Batuhxn/EMG/BOM_V4_NOTU.md

# BOM v4 notu

Mevcut `BOM.md` v2 fixed tabanidir. v4 icin buna ek olarak
`EMG_v4_EK_BOM.md` dosyasindaki parcalar eklenmelidir.

En kritik ekler:

- VREF buffer icin MCP6002'nin bos kanali kullanilacak.
- Girise dusuk kacakli dual ESD koruma ve seri direncler eklenecek.
- IN+, IN-, VREF, INA_OUT, RAW_Out, GND ve VCC test noktalari eklenecek.
- RAW_Out hattina 100 Ohm seri cikis direnci eklenebilir.

Bu not, v2 BOM dosyasinin encoding'ini bozmamak icin ayri tutuldu.
