Batuhxn/EMG/V5/BOM_V5_FINAL.md

# EMG V5 Final Purchasing BOM

> Source of truth: `V5/EMG_v5.kicad_pcb` and related current schematics/documentation on branch `v5/KiCad`. Price/stock snapshot: **2026-08-10**. The old `BOM_V5_DRAFT.md` was used only as context; the current PCB wins on conflicts.

## Scope and totals

- **49 grouped purchasing lines**, **113 required populated components**, and **2 DNP components**.
- **C304/C404 are DNP**. Nineteen PCB test pads and four mounting-hole footprints are excluded from purchasing.
- Prototype component subtotal: **86.03 USD + 363.69 TRY**. Shipping, customs and non-row VAT are excluded; the U501 TRY price includes VAT.
- Recommended buy quantities include modest prototype spares. Recheck MOQ, multiples, Turkey-region stock, incoterms and landed cost in the final carts.

| Preferred distributor | Currency | BOM lines | Recommended units | Subtotal |
|---|:---:|---:|---:|---:|
| LCSC | USD | 22 | 152 | 1.44 |
| DigiKey | USD | 23 | 117 | 63.95 |
| Not purchased | USD | 1 | 0 | 0.00 |
| Mouser | USD | 2 | 4 | 20.64 |
| Direnc.net | TRY | 1 | 1 | 363.69 |

## Verification gates

- `BAS70ZFILM` is obsolete. The priced `1N5711W-7-F` candidate is SOD-123/70V/low-capacitance Schottky class, but analog clamp leakage, Vf and capacitance need bench sign-off.
- `PMV48XP,215` had no authorized stock in the checked sources. `FDN304P` is a stocked P-channel SOT-23 candidate; G/S/D mapping, RDS(on), gate charge and inrush behavior must be approved.
- `TPS22917DBVT` is a verified packaging-only substitute for the out-of-stock `TPS22917DBVR` and is the priced purchase choice.
- `U501` is verified only as local supplier SKU `DSTK22807`; manufacturer MPN and physical 2x9 board revision/pinout remain `TBD/Verify`.
- `SW501` procurement MPN `TDA04H0SB1R` matches the electrical/lead-grid class, but the body/courtyard still needs a mechanical overlay against the KiCad footprint.
- `J301/J401` use the requested `SJ1-3523N`. `C213` is the verified `GRM32ER71A476KE15L` (47uF, 10V, X7R, 1210).

## Full purchasing table

Prices are per unit in the stated currency. `Ext.` uses the recommended buy quantity.

| RefDes | Qty / req / buy | Value | Manufacturer / exact MPN | Package / mounting | DNP | Preferred / unit / ext. | Product links | Availability | Verified alternative / compatibility | Verification status |
|---|---:|---|---|---|:---:|---|---|---|---|---|
| C203,C205,C208,C214,C215,C216,C217,C310,C311,C410,C411 | 11 / 11 / 20 | 100nF | Murata Electronics<br>`GRM188R71C104KA01D` | 0603 (1608 metric), X7R, 16V, ±10%<br>SMD | No | LCSC<br>0.006814 USD<br>0.14 USD | [buy](https://www.lcsc.com/product-detail/C45000.html)<br>[second source](https://www.digikey.com/en/products/result?keywords=GRM188R71C104KA01D) | LCSC C45000; 140,766 shown in stock. Recheck MOQ/multiple at checkout. | `CC0603KRX7R7BB104`<br>Same 0603/value/X7R class; verify voltage and DC-bias derating for the rail. | Verified – value, dielectric/tolerance and package matched; procurement MPN selected |
| C204,C206,C341,C441 | 4 / 4 / 10 | 1uF | Murata Electronics<br>`GRM21BR71C105KA01L` | 0805 (2012 metric), X7R, 16V, ±10%<br>SMD | No | DigiKey<br>0.14 USD<br>1.40 USD | [buy](https://www.digikey.com/en/products/detail/murata-electronics/GRM21BR71C105KA01L/587411)<br>[second source](https://www.mouser.com/c/?q=GRM21BR71C105KA01L) | DigiKey listing active; large stock indicated. Price basis is low-quantity cut tape; recheck cart. | `GRM21BR71C105MA01K`<br>Same 0805/1uF/16V X7R; ±20% alternative is electrically broader, not preferred for critical tolerance. | Verified – value, dielectric/tolerance and package matched; procurement MPN selected |
| C207 | 1 / 1 / 5 | 220pF | Murata Electronics<br>`GRM1885C1H221JA01D` | 0603 (1608 metric), C0G/NP0, 50V, ±5%<br>SMD | No | DigiKey<br>0.12 USD<br>0.60 USD | [buy](https://www.digikey.com/en/products/detail/murata-electronics/GRM1885C1H221JA01D/586961)<br>[second source](https://www.mouser.com/c/?q=GRM1885C1H221JA01D) | DigiKey showed 2,445 in stock; Murata part is NRND. Direct KEMET substitute available. | `C0603C221J5GACTU`<br>DigiKey-classified direct substitute; same 220pF ±5%, 50V, C0G, 0603. | Verified – exact part NRND; direct compatible alternative verified |
| C209,C210 | 2 / 2 / 5 | 2.2uF | Murata Electronics<br>`GRM21BR71A225KA01L` | 0805 (2012 metric), X7R, 10V, ±10%<br>SMD | No | DigiKey<br>0.18 USD<br>0.90 USD | [buy](https://www.digikey.com/en/products/detail/murata-electronics/GRM21BR71A225KA01L/446245)<br>[second source](https://www.mouser.com/c/?q=GRM21BR71A225KA01L) | DigiKey showed 288,072 in stock; active. | `GRM21BR71C225KA12L`<br>Upgrade: same 0805/value/tolerance/X7R with higher 16V rating; drop-in. | Verified – value, dielectric/tolerance and package matched; procurement MPN selected |
| C211,C314,C414 | 3 / 3 / 10 | 10nF | Murata Electronics<br>`GRM188R71H103KA01D` | 0603 (1608 metric), X7R, 50V, ±10%<br>SMD | No | LCSC<br>0.003957 USD<br>0.04 USD | [buy](https://www.lcsc.com/product-detail/C77053.html)<br>[second source](https://www.digikey.com/en/products/result?keywords=GRM188R71H103KA01D) | LCSC C77053; 248,887 shown in stock. Recheck MOQ/multiple. | `CC0603KRX7R9BB103`<br>Same 0603/value/X7R/50V class; drop-in after tolerance check. | Verified – value, dielectric/tolerance and package matched; procurement MPN selected |
| C212 | 1 / 1 / 5 | 2.2nF | Murata Electronics<br>`GRM1885C1H222JA01D` | 0603 (1608 metric), C0G/NP0, 50V, ±5%<br>SMD | No | LCSC<br>0.01 USD<br>0.06 USD | [buy](https://www.lcsc.com/product-detail/C77033.html)<br>[second source](https://www.digikey.com/en/products/result?keywords=GRM1885C1H222JA01D) | LCSC C77033; 24,839 shown in stock. C0G/NP0 selected for TPS22917 CT timing. | `C0603C222J5GACTU`<br>Same 0603/value/50V/C0G/±5%; drop-in. | Verified – value, dielectric/tolerance and package matched; procurement MPN selected |
| C213 | 1 / 1 / 2 | 47uF | Murata Electronics<br>`GRM32ER71A476KE15L` | 1210 (3225 metric), X7R, 10V, ±10%<br>SMD | No | LCSC<br>0.25 USD<br>0.51 USD | [buy](https://www.lcsc.com/product-detail/C84494.html)<br>[second source](https://www.digikey.com/en/products/detail/murata-electronics/GRM32ER71A476KE15L/2039039) | LCSC C84494 showed 61,880 in stock. DigiKey exact part showed 10,818; $0.91 at qty 1. | `GRM32ER71C476KE15L`<br>Potential voltage upgrade only if exact height/DC-bias and availability are confirmed; verify before substitution. | Verified – exact requested MPN, 47uF/10V/X7R/1210 confirmed |
| C218,C219 | 2 / 2 / 5 | 9.1nF | Murata Electronics<br>`GCM1885C1H912GA16D` | 0603 (1608 metric), C0G/NP0, 50V, ±2%<br>SMD | No | DigiKey<br>0.17 USD<br>0.85 USD | [buy](https://www.digikey.com/en/products/detail/murata-electronics/GCM1885C1H912GA16D/17845656)<br>[second source](https://www.mouser.com/c/?q=GCM1885C1H912GA16D) | DigiKey showed 3,820 in stock; Mouser also showed >10k region stock. TME exact part was out of stock. | `GCM1885C1H912JA16D`<br>Same value/package/voltage/C0G with ±5% tolerance; use only if filter tolerance budget allows. | Verified – value, dielectric/tolerance and package matched; procurement MPN selected |
| C301,C302,C401,C402 | 4 / 4 / 10 | 100pF | Murata Electronics<br>`GRM1885C1H101JA01D` | 0603 (1608 metric), C0G/NP0, 50V, ±5%<br>SMD | No | LCSC<br>0.009400 USD<br>0.09 USD | [buy](https://www.lcsc.com/product-detail/C71664.html)<br>[second source](https://www.digikey.com/en/products/result?keywords=GRM1885C1H101JA01D) | LCSC C71664; 20,137 shown in stock. Recheck MOQ/multiple. | `C0603C101J5GACTU`<br>Same 0603/value/50V/C0G/±5%; drop-in. | Verified – value, dielectric/tolerance and package matched; procurement MPN selected |
| C303,C403 | 2 / 2 / 5 | 470pF | Murata Electronics<br>`GRM1885C1H471JA01D` | 0603 (1608 metric), C0G/NP0, 50V, ±5%<br>SMD | No | LCSC<br>0.005614 USD<br>0.03 USD | [buy](https://www.lcsc.com/product-detail/C85979.html)<br>[second source](https://www.digikey.com/en/products/result?keywords=GRM1885C1H471JA01D) | LCSC C85979; 25,277 shown in stock. Recheck MOQ/multiple. | `C0603C471J5GACTU`<br>Same 0603/value/50V/C0G/±5%; drop-in. | Verified – value, dielectric/tolerance and package matched; procurement MPN selected |
| C304,C404 | 2 / 0 / 0 | 100pF DNP | Murata Electronics<br>`GRM1885C1H101JA01D` | 0603 (1608 metric), C0G/NP0, 50V, ±5%<br>SMD | Yes | Not purchased<br>0.000000 USD<br>0.00 USD | [buy](https://www.lcsc.com/product-detail/C71664.html)<br>[second source](https://www.digikey.com/en/products/result?keywords=GRM1885C1H101JA01D) | Explicit DNP per PCB; pads remain unpopulated. | `N/A`<br>Do not populate unless the analog filter is intentionally retuned and revalidated. | Verified – DNP flag confirmed on current PCB |
| C321,C331,C421,C431 | 4 / 4 / 10 | 1nF | KEMET<br>`C0805C102J5GACTU` | 0805 (2012 metric), C0G/NP0, 50V, ±5%<br>SMD | No | DigiKey<br>0.12 USD<br>1.20 USD | [buy](https://www.digikey.com/en/products/detail/kemet/C0805C102J5GACTU/411411)<br>[second source](https://www.mouser.com/c/?q=C0805C102J5GACTU) | DigiKey showed 409,004 in stock; active. | `GRM2165C1H102JA01J`<br>DigiKey-classified direct substitute; same 1nF/50V/C0G/0805. | Verified – value, dielectric/tolerance and package matched; procurement MPN selected |
| C351,C451 | 2 / 2 / 5 | 4.7nF | KEMET<br>`C0805C472J5GACTU` | 0805 (2012 metric), C0G/NP0, 50V, ±5%<br>SMD | No | DigiKey<br>0.57 USD<br>2.85 USD | [buy](https://www.digikey.com/en/products/detail/kemet/C0805C472J5GACTU/2212835)<br>[second source](https://www.mouser.com/c/?q=C0805C472J5GACTU) | DigiKey showed 13,585 in stock; active. | `C2012C0G1H472J125AA`<br>Same value/package/50V/C0G/±5%; verify thickness but electrically drop-in. | Verified – value, dielectric/tolerance and package matched; procurement MPN selected |
| C360,C460 | 2 / 2 / 5 | 100nF | KEMET<br>`C0805C104K5RACTU` | 0805 (2012 metric), X7R, 50V, ±10%<br>SMD | No | DigiKey<br>0.16 USD<br>0.80 USD | [buy](https://www.digikey.com/en/products/detail/kemet/C0805C104K5RACTU/411169)<br>[second source](https://www.mouser.com/c/?q=C0805C104K5RACTU) | DigiKey showed 5,631,275 in stock; active. | `CC0805KRX7R9BB104`<br>Same value/package/50V/X7R/±10%; drop-in. | Verified – value, dielectric/tolerance and package matched; procurement MPN selected |
| D331,D332,D431,D432 | 4 / 4 / 5 | BAS70ZFILM | STMicroelectronics<br>`BAS70ZFILM` | SOD-123<br>SMD | No | DigiKey<br>0.23 USD<br>1.15 USD | [buy](https://www.digikey.com/en/products/detail/diodes-incorporated/1N5711W-7-F/808531)<br>[second source](https://www.digikey.com/en/products/detail/stmicroelectronics/BAS70ZFILM/1299858) | Original BAS70ZFILM is obsolete/no stock. Price and availability use the listed alternative; 1N5711W-7-F showed ~29k in stock. | `1N5711W-7-F`<br>Same SOD-123, 70V low-capacitance Schottky class. DigiKey marks it direct for 1N5711W; analog clamp leakage/Vf/capacitance must be bench-verified against BAS70 behavior. | Verify before order – original obsolete; alternative is not formally manufacturer-qualified as BAS70 drop-in |
| J201 | 1 / 1 / 2 | B2B-XH-A(LF)(SN) | JST Sales America<br>`B2B-XH-A(LF)(SN)` | JST XH, 2-position, 2.50mm pitch, vertical<br>THT | No | Mouser<br>0.10 USD<br>0.20 USD | [buy](https://www.mouser.com/ProductDetail/JST-Commercial/B2B-XH-ALFSN)<br>[second source](https://www.digikey.com/en/products/result?keywords=B2B-XH-A(LF)(SN)) | Mouser showed tens of thousands globally; low-quantity price about $0.10. Recheck Turkey region at cart. | `B2B-XH-AM(LF)(SN)`<br>Similar JST XH header; verify boss/retention and exact PCB hole geometry before substitution. | Verified – exact JST MPN and 2-pin vertical THT package |
| J301,J401 | 2 / 2 / 3 | SJ1-3523N | Same Sky (formerly CUI Devices)<br>`SJ1-3523N` | 3.5mm stereo audio jack, right-angle PCB<br>THT | No | DigiKey<br>1.06 USD<br>3.18 USD | [buy](https://www.digikey.com/en/products/detail/same-sky-formerly-cui-devices/SJ1-3523N/738689)<br>[second source](https://www.mouser.com/ProductDetail/Same-Sky/SJ1-3523N) | DigiKey showed 234,333 in stock; active. | `TBD/Verify`<br>No second MPN approved. Jack pinout and board drill pattern are mechanical-critical. | Verified – user-specified MPN; THT right-angle TRS pinout/package confirmed |
| Q201 | 1 / 1 / 2 | PMV48XP | Nexperia<br>`PMV48XP,215` | SOT-23-3 (TO-236AB)<br>SMD | No | DigiKey<br>0.82 USD<br>1.64 USD | [buy](https://www.digikey.com/en/products/detail/onsemi/FDN304P/965599)<br>[second source](https://www.mouser.com/ProductDetail/Nexperia/PMV48XP215) | Original PMV48XP,215 showed no authorized stock. Price uses FDN304P; DigiKey showed 36,114 in stock. | `FDN304P`<br>P-channel 20V SOT-23 with 1.8V/4.5V drive. Same package class; verify G/S/D pad mapping, RDS(on), gate charge and inrush behavior before release. | Verify before order – functional alternative identified; engineering sign-off required |
| R201,R202 | 2 / 2 / 5 | 47k | YAGEO<br>`RC0805FR-0747KL` | 0805 (2012 metric), 1%, 1/8W<br>SMD | No | LCSC<br>0.004200 USD<br>0.02 USD | [buy](https://www.lcsc.com/product-detail/C126351.html)<br>[second source](https://www.digikey.com/en/products/result?keywords=RC0805FR-0747KL) | LCSC C126351; 172,145 shown in stock. | `ERJ-6ENF4702V`<br>Same 47k/1%/0805 power class; drop-in. | Verified – value, tolerance/power class and package matched; procurement MPN selected |
| R203 | 1 / 1 / 5 | 1k | YAGEO<br>`RC0603FR-071KL` | 0603 (1608 metric), 1%, 0.1W<br>SMD | No | LCSC<br>0.000943 USD<br>0.00 USD | [buy](https://www.lcsc.com/product-detail/C22548.html)<br>[second source](https://www.digikey.com/en/products/result?keywords=RC0603FR-071KL) | LCSC C22548; 5,102,062 shown in stock. | `ERJ-3EKF1001V`<br>Same 1k/1%/0603 power class; drop-in. | Verified – value, tolerance/power class and package matched; procurement MPN selected |
| R204 | 1 / 1 / 5 | 68k | YAGEO<br>`RC0805FR-0768KL` | 0805 (2012 metric), 1%, 1/8W<br>SMD | No | LCSC<br>0.004200 USD<br>0.02 USD | [buy](https://www.lcsc.com/product-detail/C114548.html)<br>[second source](https://www.digikey.com/en/products/result?keywords=RC0805FR-0768KL) | LCSC C114548; 165,801 shown in stock. | `ERJ-6ENF6802V`<br>Same 68k/1%/0805 power class; drop-in. | Verified – value, tolerance/power class and package matched; procurement MPN selected |
| R205,R311,R411 | 3 / 3 / 10 | 100k | YAGEO<br>`RC0805FR-07100KL` | 0805 (2012 metric), 1%, 1/8W<br>SMD | No | DigiKey<br>0.10 USD<br>1.00 USD | [buy](https://www.digikey.com/en/products/result?keywords=RC0805FR-07100KL)<br>[second source](https://www.lcsc.com/product-detail/C96346.html) | LCSC showed only 9 units, below recommended buy. DigiKey selected for adequate stock; recheck cut-tape tier. | `ERJ-6ENF1003V`<br>Same 100k/1%/0805 power class; drop-in. | Verified – value, tolerance/power class and package matched; procurement MPN selected |
| R206,R207 | 2 / 2 / 5 | 0R | YAGEO<br>`RC0603FR-070RL` | 0603 (1608 metric), jumper, 0.1W<br>SMD | No | LCSC<br>0.000943 USD<br>0.00 USD | [buy](https://www.lcsc.com/product-detail/C100044.html)<br>[second source](https://www.digikey.com/en/products/result?keywords=RC0603FR-070RL) | LCSC C100044; 1,323,481 shown in stock. | `ERJ-3GEY0R00V`<br>Same 0603 zero-ohm jumper class; drop-in. | Verified – value, tolerance/power class and package matched; procurement MPN selected |
| R208 | 1 / 1 / 5 | 10k | YAGEO<br>`RC0603FR-0710KL` | 0603 (1608 metric), 1%, 0.1W<br>SMD | No | LCSC<br>0.000957 USD<br>0.00 USD | [buy](https://www.lcsc.com/product-detail/C98220.html)<br>[second source](https://www.digikey.com/en/products/result?keywords=RC0603FR-0710KL) | LCSC C98220; 5,570,515 shown in stock. | `ERJ-3EKF1002V`<br>Same 10k/1%/0603 power class; drop-in. | Verified – value, tolerance/power class and package matched; procurement MPN selected |
| R209 | 1 / 1 / 5 | 47k 1% | YAGEO<br>`RC0603FR-0747KL` | 0603 (1608 metric), 1%, 0.1W<br>SMD | No | LCSC<br>0.001071 USD<br>0.01 USD | [buy](https://www.lcsc.com/product-detail/C105579.html)<br>[second source](https://www.digikey.com/en/products/result?keywords=RC0603FR-0747KL) | LCSC C105579; 767,590 shown in stock. | `ERJ-3EKF4702V`<br>Same 47k/1%/0603 power class; drop-in. | Verified – value, tolerance/power class and package matched; procurement MPN selected |
| R210 | 1 / 1 / 5 | 220k 1% | YAGEO<br>`RC0603FR-07220KL` | 0603 (1608 metric), 1%, 0.1W<br>SMD | No | LCSC<br>0.001900 USD<br>0.01 USD | [buy](https://www.lcsc.com/product-detail/C123420.html)<br>[second source](https://www.digikey.com/en/products/result?keywords=RC0603FR-07220KL) | LCSC C123420; 12,230 shown in stock. | `ERJ-3EKF2203V`<br>Same 220k/1%/0603 power class; drop-in. | Verified – value, tolerance/power class and package matched; procurement MPN selected |
| R301,R302,R401,R402 | 4 / 4 / 10 | 100k | YAGEO<br>`RC1206FR-07100KL` | 1206 (3216 metric), 1%, 1/4W<br>SMD | No | DigiKey<br>0.10 USD<br>1.00 USD | [buy](https://www.digikey.com/en/products/detail/yageo/RC1206FR-07100KL/728492)<br>[second source](https://www.mouser.com/c/?q=RC1206FR-07100KL) | DigiKey showed >700k exact-part availability in substitute listing context; active. | `ERJ-8ENF1003V`<br>Same 100k/1%/1206 power class; drop-in. | Verified – value, tolerance/power class and package matched; procurement MPN selected |
| R303,R403 | 2 / 2 / 5 | 220k | YAGEO<br>`RC1206FR-07220KL` | 1206 (3216 metric), 1%, 1/4W<br>SMD | No | LCSC<br>0.005800 USD<br>0.03 USD | [buy](https://www.lcsc.com/product-detail/C130275.html)<br>[second source](https://www.digikey.com/en/products/detail/yageo/RC1206FR-07220KL/728694) | LCSC C130275 showed 9 units; enough for recommended buy of 5, but recheck before checkout. | `ERJ-8ENF2203V`<br>Same 220k/1%/1206 power class; drop-in. | Verified – value, tolerance/power class and package matched; procurement MPN selected |
| R304,R305,R404,R405 | 4 / 4 / 10 | 10M | YAGEO<br>`RC1206FR-0710ML` | 1206 (3216 metric), 1%, 1/4W<br>SMD | No | LCSC<br>0.006300 USD<br>0.06 USD | [buy](https://www.lcsc.com/product-detail/C275643.html)<br>[second source](https://www.digikey.com/en/products/detail/yageo/RC1206FR-0710ML/728484) | LCSC C275643; 176 shown in stock. High-impedance node: keep board clean and verify leakage. | `CRCW120610M0FKEA`<br>Same 10M/1%/1206 class; verify voltage coefficient and max working voltage. | Verified – value, tolerance/power class and package matched; procurement MPN selected |
| R306,R406 | 2 / 2 / 5 | 2.2M | YAGEO<br>`RC1206FR-072M2L` | 1206 (3216 metric), 1%, 1/4W<br>SMD | No | LCSC<br>0.005500 USD<br>0.03 USD | [buy](https://www.lcsc.com/product-detail/C137329.html)<br>[second source](https://www.digikey.com/en/products/result?keywords=RC1206FR-072M2L) | LCSC C137329 showed 8 units; enough for recommended buy of 5, but recheck. | `CRCW12062M20FKEA`<br>Same 2.2M/1%/1206 class; verify voltage coefficient and working voltage. | Verified – value, tolerance/power class and package matched; procurement MPN selected |
| R307,R407 | 2 / 2 / 5 | 4.99k 0.1% RG | YAGEO<br>`RT0805BRD074K99L` | 0805 (2012 metric), thin film, 0.1%, 25ppm/°C<br>SMD | No | LCSC<br>0.05 USD<br>0.25 USD | [buy](https://www.lcsc.com/product-detail/C706246.html)<br>[second source](https://www.digikey.com/en/products/result?keywords=RT0805BRD074K99L) | LCSC C706246; 23,625 shown in stock. Precision gain resistor selection. | `TNPW08054K99BEEA`<br>Same 4.99k/0.1%/0805 precision thin-film class; verify TCR and power rating. | Verified – precision value, 0.1% tolerance and 0805 package matched |
| R313,R413 | 2 / 2 / 5 | 40.2k | YAGEO<br>`RC0805FR-0740K2L` | 0805 (2012 metric), 1%, 1/8W<br>SMD | No | LCSC<br>0.004100 USD<br>0.02 USD | [buy](https://www.lcsc.com/product-detail/C273827.html)<br>[second source](https://www.digikey.com/en/products/result?keywords=RC0805FR-0740K2L) | LCSC C273827; 197 shown in stock. | `ERJ-6ENF4022V`<br>Same 40.2k/1%/0805 power class; drop-in. | Verified – value, tolerance/power class and package matched; procurement MPN selected |
| R314,R341,R414,R441 | 4 / 4 / 10 | 33k | YAGEO<br>`RC0805FR-0733KL` | 0805 (2012 metric), 1%, 1/8W<br>SMD | No | LCSC<br>0.003500 USD<br>0.04 USD | [buy](https://www.lcsc.com/product-detail/C141696.html)<br>[second source](https://www.digikey.com/en/products/result?keywords=RC0805FR-0733KL) | LCSC C141696; 1,781 shown in stock. | `ERJ-6ENF3302V`<br>Same 33k/1%/0805 power class; drop-in. | Verified – value, tolerance/power class and package matched; procurement MPN selected |
| R321,R331,R351,R421,R431,R451 | 6 / 6 / 10 | 470R | YAGEO<br>`RC0805FR-07470RL` | 0805 (2012 metric), 1%, 1/8W<br>SMD | No | LCSC<br>0.003500 USD<br>0.04 USD | [buy](https://www.lcsc.com/product-detail/C114564.html)<br>[second source](https://www.digikey.com/en/products/result?keywords=RC0805FR-07470RL) | LCSC C114564; 280,999 shown in stock. | `ERJ-6ENF4700V`<br>Same 470R/1%/0805 power class; drop-in. | Verified – value, tolerance/power class and package matched; procurement MPN selected |
| R312,R333,R334,R337,R412,R433,R434,R437 | 8 / 8 / 20 | 10k | YAGEO<br>`RC0805FR-0710KL` | 0805 (2012 metric), 1%, 1/8W<br>SMD | No | DigiKey<br>0.10 USD<br>2.00 USD | [buy](https://www.digikey.com/en/products/detail/yageo/RC0805FR-0710KL/727535)<br>[second source](https://www.lcsc.com/product-detail/C84376.html) | LCSC showed only 2 units; DigiKey selected for adequate stock. Active exact MPN. | `ERJ-6ENF1002V`<br>Same 10k/1%/0805 power class; drop-in. | Verified – value, tolerance/power class and package matched; procurement MPN selected |
| R335,R435 | 2 / 2 / 5 | 1M | YAGEO<br>`RC0805FR-071ML` | 0805 (2012 metric), 1%, 1/8W<br>SMD | No | LCSC<br>0.002043 USD<br>0.01 USD | [buy](https://www.lcsc.com/product-detail/C107700.html)<br>[second source](https://www.digikey.com/en/products/result?keywords=RC0805FR-071ML) | LCSC C107700; 247,404 shown in stock. | `ERJ-6ENF1004V`<br>Same 1M/1%/0805 power class; drop-in. | Verified – value, tolerance/power class and package matched; procurement MPN selected |
| R336,R338,R436,R438 | 4 / 4 / 10 | 20k | YAGEO<br>`RC0805FR-0720KL` | 0805 (2012 metric), 1%, 1/8W<br>SMD | No | LCSC<br>0.003600 USD<br>0.04 USD | [buy](https://www.lcsc.com/product-detail/C114566.html)<br>[second source](https://www.digikey.com/en/products/result?keywords=RC0805FR-0720KL) | LCSC C114566 showed 23 units; enough for recommended buy of 10, but recheck. | `ERJ-6ENF2002V`<br>Same 20k/1%/0805 power class; drop-in. | Verified – value, tolerance/power class and package matched; procurement MPN selected |
| SW201 | 1 / 1 / 2 | TS02CQE | C&K<br>`TS02CQE` | TS series miniature slide switch, SPST ON-OFF<br>THT | No | Mouser<br>10.22 USD<br>20.44 USD | [buy](https://www.mouser.com/en/ProductDetail/CK/TS02CQE)<br>[second source](https://fr.farnell.com/en-FR/c-k-partner-stock/ts02cqe/switch-slide-spst-1a-120v/dp/4556613) | Mouser showed 412 in stock, min/multiple 1. Farnell partner stock existed but min/multiple 15. | `TBD/Verify`<br>No mechanically verified alternative approved; actuator and pin geometry are footprint-critical. | Verified – exact MPN and THT SPST function; stock available |
| SW501 | 1 / 1 / 2 | DEBUG_CFG | C&K<br>`TDA04H0SB1R` | 4-position SPST DIP slide, 7.62mm row spacing, 2.54mm pitch<br>THT | No | DigiKey<br>3.73 USD<br>7.46 USD | [buy](https://www.digikey.com/en/products/detail/c-k/TDA04H0SB1R/1961415)<br>[second source](https://www.mouser.com/c/?q=TDA04H0SB1R) | DigiKey direct-substitute listing showed 12,339 in stock. | `78B04ST`<br>Electrical class and lead grid are plausible; neither candidate's body/courtyard has been overlaid against the custom KiCad footprint. Mechanical verification required. | Verify before order – selected exact procurement MPN, mechanical fit not yet signed off |
| U201 | 1 / 1 / 2 | MCP3208-CI/P | Microchip Technology<br>`MCP3208-CI/P` | PDIP-16, 0.300in<br>THT | No | DigiKey<br>2.78 USD<br>5.56 USD | [buy](https://www.digikey.com/en/products/detail/microchip-technology/MCP3208-CI-P/305928)<br>[second source](https://www.mouser.com/c/?q=MCP3208-CI%2FP) | DigiKey showed 693 in stock; active. | `MCP3208-BI/P`<br>Same PDIP-16 pinout and function; B grade has tighter accuracy. Drop-in. | Verified – exact MPN/package aligned with PCB and repository review |
| U202 | 1 / 1 / 2 | MCP6002-I/SN | Microchip Technology<br>`MCP6002-I/SN` | SOIC-8, 3.9mm body<br>SMD | No | DigiKey<br>0.41 USD<br>0.82 USD | [buy](https://www.digikey.com/en/products/detail/microchip-technology/MCP6002-I-SN/500876)<br>[second source](https://www.mouser.com/c/?q=MCP6002-I%2FSN) | DigiKey showed 16,456 in stock; active. | `MCP6002T-I/SN`<br>Packaging-quantity suffix only; same silicon and SOIC-8 package. Drop-in. | Verified – exact MPN/package |
| U203 | 1 / 1 / 2 | TPS7A2033PDBVR | Texas Instruments<br>`TPS7A2033PDBVR` | SOT-23-5 (DBV)<br>SMD | No | DigiKey<br>0.35 USD<br>0.70 USD | [buy](https://www.digikey.com/en/products/detail/texas-instruments/TPS7A2033PDBVR/13566866)<br>[second source](https://www.mouser.com/c/?q=TPS7A2033PDBVR) | DigiKey showed 23,888 in stock; active. | `TPS7A2033PDBVT`<br>Packaging-quantity code; same DBV package and electrical device. Drop-in. | Verified – exact MPN/package |
| U204 | 1 / 1 / 2 | TPS22917DBVR | Texas Instruments<br>`TPS22917DBVR` | SOT-23-6 (DBV)<br>SMD | No | DigiKey<br>1.14 USD<br>2.28 USD | [buy](https://www.digikey.com/en/products/detail/texas-instruments/TPS22917DBVT/8567084)<br>[second source](https://www.digikey.com/en/products/detail/texas-instruments/TPS22917DBVR/8539916) | Original DBVR cut-tape listing showed 0 stock. DBVT packaging alternative showed ~6.9k in stock; price uses DBVT. | `TPS22917DBVT`<br>Same TPS22917 silicon and DBV package; R/T suffix is orderable packaging quantity. Drop-in. | Verified – packaging-only alternative approved for purchase |
| U205 | 1 / 1 / 2 | TXU0304PWR | Texas Instruments<br>`TXU0304PWR` | TSSOP-14 (PW)<br>SMD | No | DigiKey<br>0.99 USD<br>1.98 USD | [buy](https://www.digikey.com/en/products/detail/texas-instruments/TXU0304PWR/14641423)<br>[second source](https://www.mouser.com/c/?q=TXU0304PWR) | DigiKey showed 32,788 in stock; active. | `TXU0304PWT`<br>Likely packaging-quantity variant in the same PW package; verify TI ordering table before substitution. | Verified – exact MPN/package; alternative marked Verify |
| U206 | 1 / 1 / 2 | TPS3899DL30DSER | Texas Instruments<br>`TPS3899DL30DSER` | WSON-6, 1.5mm x 1.5mm (DSE)<br>SMD | No | DigiKey<br>1.47 USD<br>2.94 USD | [buy](https://www.digikey.com/en/products/detail/texas-instruments/TPS3899DL30DSER/15205114)<br>[second source](https://www.mouser.com/c/?q=TPS3899DL30DSER) | DigiKey showed 3,177 in stock; active. | `TPS3899DL30DSET`<br>Packaging-quantity variant expected in same DSE package; verify TI ordering table before substitution. | Verified – exact threshold MPN/package; alternative marked Verify |
| U207 | 1 / 1 / 2 | TPS3899DL29DSER | Texas Instruments<br>`TPS3899DL29DSER` | WSON-6, 1.5mm x 1.5mm (DSE)<br>SMD | No | DigiKey<br>1.47 USD<br>2.94 USD | [buy](https://www.digikey.com/en/products/detail/texas-instruments/TPS3899DL29DSER/15205155)<br>[second source](https://www.mouser.com/c/?q=TPS3899DL29DSER) | DigiKey showed 1,731 in stock; active. | `TPS3899DL29DSET`<br>Packaging-quantity variant expected in same DSE package; verify TI ordering table before substitution. | Verified – exact threshold MPN/package; alternative marked Verify |
| U301,U401 | 2 / 2 / 3 | INA333AIDGKT | Texas Instruments<br>`INA333AIDGKT` | VSSOP-8 (DGK)<br>SMD | No | DigiKey<br>6.36 USD<br>19.08 USD | [buy](https://www.digikey.com/en/products/detail/texas-instruments/INA333AIDGKT/1888776)<br>[second source](https://www.mouser.com/c/?q=INA333AIDGKT) | DigiKey showed 3,013 in stock; active. | `INA333AIDGKR`<br>Same device and DGK VSSOP-8 package; packaging-quantity suffix only. Drop-in. | Verified – exact MPN and custom PCB footprint package |
| U302,U402 | 2 / 2 / 3 | MCP6004-I/SL | Microchip Technology<br>`MCP6004-I/SL` | SOIC-14, 3.9mm body<br>SMD | No | DigiKey<br>0.54 USD<br>1.62 USD | [buy](https://www.digikey.com/en/products/detail/microchip-technology/MCP6004T-I-SL/523092)<br>[second source](https://www.digikey.com/en/products/detail/microchip-technology/MCP6004-I-SL/523061) | Tube MPN has MOQ 57. Cut-tape MCP6004T-I/SL showed 20,395 in stock; price uses T suffix. | `MCP6004T-I/SL`<br>Same silicon and SOIC-14 package; tape-and-reel ordering suffix. Drop-in. | Verified – packaging-only alternative selected to avoid tube MOQ |
| U501 | 1 / 1 / 1 | DSTK22807 / ESP32-H2 Super Mini | TBD/Verify (generic module)<br>`TBD/Verify; supplier SKU DSTK22807` | ESP32-H2 Super Mini dev board on custom 2x9 THT carrier<br>Module / THT headers | No | Direnc.net<br>363.69 TRY<br>363.69 TRY | [buy](https://www.direnc.net/esp32-h2-super-mini-bluetooth-board)<br>TBD/Verify | Direnc.net page showed 47 units; 303.07 TRY + VAT / 363.69 TRY incl. VAT. | `TBD/Verify`<br>No generic 'ESP32-H2 Super Mini' may be assumed drop-in. Physical board revision, 2x9 pin order, 3V3/GND and SPI pins must match repository measurement checklist. | Verify before order – supplier SKU is verified; manufacturer MPN and physical pinout are not |

## Checkout notes

- Prefer DigiKey/Mouser for ICs, semiconductors, connectors and switches where authenticity or lifecycle risk matters. LCSC is used only for exact, high-stock passive MPNs in this prototype plan.
- LCSC API/listing prices may reflect a displayed quantity tier; confirm MOQ and order multiple before checkout.
- All product URLs, second-source URLs, stock notes, alternatives and verification states are also preserved in the Excel deliverable.
