Batuhxn/EMG/EMG_v2_BOM_FIXED.xlsx

Sheet: BOM
Category | Ref | Value / MPN | Package | Qty | Purpose / Notes | Suggested source
IC | U1 | INA333AIDGKR | VSSOP-8 SMD | 1 | Instrumentation amplifier. Small SMD package; hot air or fine soldering needed. | direnc.net / Hepsiburada / Mouser
IC | U2 | MCP6002-I/P | DIP-8 THT | 1 | Dual rail-to-rail op-amp. | komponentci.net / entegredunyasi.com.tr / local
Resistor | Rg1, R2, R3 | 10 kOhm | Axial THT 1/4W | 3 | VREF divider and gain/bias network. | direnc.net / local
Resistor | R4, R5 | 2.2 kOhm | Axial THT 1/4W | 2 | Input series resistors. | direnc.net / local
Resistor | R6 | 4.7 kOhm | Axial THT 1/4W | 1 | High-pass bias resistor. | direnc.net / local
Resistor | R7 | 1 MOhm | Axial THT 1/4W | 1 | BODY_REF bias resistor. | direnc.net / local
Resistor | R8 | 1 kOhm | Axial THT 1/4W | 1 | RAW_Out low-pass filter resistor. | direnc.net / local
Resistor | Rf1 | 100 kOhm | Axial THT 1/4W | 1 | MCP6002 feedback resistor. | direnc.net / local
Resistor | Rg_HPF1 | 10 kOhm | Axial THT 1/4W | 1 | INA333 gain resistor. | direnc.net / local
Capacitor | C2, C5, C6 | 100 nF | Disc ceramic THT, 5 mm pitch | 3 | Bypass / reference decoupling capacitors. | direnc.net / local
Capacitor | C3 | 10 uF | Radial electrolytic D5 x P2.5 mm | 1 | VREF filtering. Observe polarity. | direnc.net / local
Capacitor | C4 | 2.2 uF | Film/polyester THT, 5 mm pitch | 1 | Critical high-pass capacitor. Do not use polarized electrolytic here. | direnc.net / komponentci.net
Capacitor | Cf2 | 330 nF | Disc ceramic or film THT, 5 mm pitch | 1 | RAW_Out low-pass filter capacitor. | direnc.net / komponentci.net
Connector | J1 | Pin Header 1x3 | 2.54 mm vertical THT | 1 | Electrode input: IN+, IN-, BODY_REF. | direnc.net / robotistan.com / local
Connector | J2 | Pin Header 1x4 | 2.54 mm vertical THT | 1 | Power/output: VCC, RAW_Out, VREF, GND. | direnc.net / robotistan.com / local

Sheet: Notes
Item | Status / Note
Project copy | Generated from EMG_v2_working_package_FIXED.
PCB sync | C2 is present on PCB as 100 nF between VREF and GND.
Gerbers | Gerbers must be regenerated from the FIXED KiCad project before fabrication.
Remaining layout warning | IN+ / IN- trace length mismatch remains; acceptable for low-frequency EMG but symmetry can be improved.
Safety | Input ESD / patient-side protection is still not implemented. Use battery power for any body-connected test.
No MPN coverage | Most passives are generic values; choose concrete manufacturer part numbers before production ordering.
