Batuhxn/EMG/EMG_v4_BOM_ve_Validasyon.xlsx

Sheet: v4 BOM
Grup | Ref | Deger / Parca | Paket | Adet | Durum | Not
IC | U1 | INA333AIDGKR | VSSOP-8 | 1 | Mevcut | Enstrumantasyon amplifikatoru
IC | U2 | MCP6002-I/P | DIP-8 | 1 | Mevcut | U2B VREF buffer olarak kullanilacak
Direnc | R2, R3 | 10 kOhm %1 | Axial THT | 2 | Mevcut | VREF_RAW bolucu
Direnc | Rg1, Rg_HPF1 | 10 kOhm %1 | Axial THT | 2 | Mevcut | Kazanc / filtre agi
Direnc | R4, R5 | 2.2 kOhm veya v4'te 10 kOhm | Axial THT | 2 | Revize | Giris seri koruma netlestirilecek
Direnc | R6 | 4.7 kOhm | Axial THT | 1 | Mevcut | HPF bias
Direnc | R7 | 1 MOhm | Axial THT | 1 | Mevcut | BODY_REF bias
Direnc | R8 | 1 kOhm | Axial THT | 1 | Mevcut | LPF seri direnc
Direnc | Rf1 | 100 kOhm | Axial THT | 1 | Mevcut | MCP6002 geri besleme
Direnc | R_INP | 10 kOhm %1 | Axial THT | 1 | Yeni | IN+ seri koruma
Direnc | R_INN | 10 kOhm %1 | Axial THT | 1 | Yeni | IN- seri koruma
Direnc | R_OUT | 100 Ohm | Axial THT | 1 | Yeni | RAW_Out seri cikis direnci
Kondansator | C2, C5, C6 | 100 nF | THT 5 mm | 3 | Mevcut | Bypass / VREF filtreleme
Kondansator | C3 | 10 uF | Radial THT | 1 | Mevcut | VREF filtreleme, polarite kontrol
Kondansator | C4 | 2.2 uF film/polyester | THT 5 mm | 1 | Mevcut kritik | Non-polar olmali
Kondansator | Cf2 | 330 nF | THT 5 mm | 1 | Mevcut | LPF kondansatoru
Kondansator | C_DIFF | 1 nF C0G/NP0 | THT/SMD | 1 | Yeni | IN+ ile IN- arasi RF bastirma
Kondansator | C_CM_P, C_CM_N | 100 pF C0G/NP0 | THT/SMD | 2 | Yeni opsiyonel | VREF'e ortak-mod RF bastirma, DNP olabilir
Koruma | D1 | Low leakage dual ESD diode | SOT-23/SOT-563 | 1 | Yeni | IN+ ve IN- giris ESD koruma
Konnektor | J1 | 1x3 erkek pin header | 2.54 mm THT | 1 | Mevcut | IN+, IN-, BODY_REF
Konnektor | J2 | 1x4 erkek pin header | 2.54 mm THT | 1 | Mevcut | VCC, RAW_Out, VREF, GND
Test | TP1-TP7 | Test point | THT/SMD pad | 7 | Yeni | IN+, IN-, VREF, INA_OUT, RAW_Out, GND, VCC

Sheet: Tasarim Kararlari
Baslik | Karar
VREF | R2/R3 orta noktasi VREF_RAW; U2B voltage follower cikisi VREF olacak.
Giris koruma | Seri direnc + dusuk kacakli ESD + C_DIFF eklenecek.
Elektrot | Ag/AgCl jel elektrot, 20 mm hedef aralik, kas lifine paralel.
Guc | Insan testinde sadece batarya; prize/USB'ye bagli sistemle vucut baglanmayacak.
Gerber | v4 Gerber bu ortamda uretilmedi; KiCad'de DRC/ERC sonrasi export edilecek.

Sheet: Validasyon
Test | Kabul kriteri | Sonuc | Not
Gorsel kontrol | Lehim koprusu yok, C3 polarite dogru, C4 non-polar
VREF 3.3V | 1.65 V +/- 5%
VREF 5V | 2.50 V +/- 5%
Frekans 20-250 Hz | Kullanilabilir genlik, raylara yapisma yok
500 Hz | LPF etkisi baslamis olmali
Gurultu | IN+/IN- VREF'e bagliyken RAW_Out VREF civarinda
Insan hafif kasilma | RMS dinlenmeden belirgin yuksek
Insan guclu kasilma | RMS hafiften yuksek, clipping yok

Sheet: Kaynaklar
Konu | Kaynak
SENIAM elektrot yerlesimi | https://seniam.org/fixation.htm
ADI biopotansiyel elektrotlar | https://www.analog.com/en/resources/technical-articles/biopotential-electrode-sensors-ecg-eeg-emg.html
TI INA333 datasheet | https://www.ti.com/lit/ds/symlink/ina333.pdf
FDA EMG siniflandirma | https://www.law.cornell.edu/cfr/text/21/890.1375
IEC 60601 genel guvenlik | https://www.vde.com/topics-en/health/consulting/electrical-safety-in-active-medical-devices--the-iec-60601-1-standard
