Batuhxn/EMG/EMG_kullanilacak_komponentler_BoM.xlsx

Sheet: EMG BoM
kullanım biçimi / tasarım | Sensör Model Adı ve No | Tedarikçi Linki | Stok Durumu | Birim Fiyat | (Varsa) Alternatif öneri | Modülün ürettiği veri çıkışı | Haberleşme Protokolü | makale kaynağı
EMG Sensör | INA333AIDGKR Enstrümantasyon Op-Amp | https://www.direnc.net/ina333aidgkr-smd-amplifikator-entegresi-vssop8-en | kontrol edilecek |  | INA333 muadili, aynı VSSOP-8 pinout doğrulanmalı | Analog EMG ön yükseltme | Analog
EMG Sensör | MCP6002-I/P Op-Amp | https://www.komponentci.net/mcp6002-i-p-islemsel-amplifikator-entegresi-dip-8-pmu9149 | kontrol edilecek |  | MCP6002 DIP-8 veya aynı pinout rail-to-rail çift op-amp | Kazanç ve filtre katı | Analog
EMG Sensör | 10 kΩ direnç |  | kontrol edilecek |  | 1/4W axial THT, %1 önerilir | Rg1, R2, R3, Rg_HPF1 için | Pasif
EMG Sensör | 2.2 kΩ direnç |  | kontrol edilecek |  | 1/4W axial THT, %1 önerilir | R4, R5 giriş seri dirençleri | Pasif
EMG Sensör | 4.7 kΩ direnç |  | kontrol edilecek |  | 1/4W axial THT, %1 önerilir | R6 HPF bias direnci | Pasif
EMG Sensör | 1 MΩ direnç |  | kontrol edilecek |  | 1/4W axial THT, %1 önerilir | R7 BODY_REF bias direnci | Pasif
EMG Sensör | 1 kΩ direnç |  | kontrol edilecek |  | 1/4W axial THT, %1 önerilir | R8 RAW_Out filtre direnci | Pasif
EMG Sensör | 100 kΩ direnç |  | kontrol edilecek |  | 1/4W axial THT, %1 önerilir | Rf1 geri besleme direnci | Pasif
EMG Sensör | 100 nF seramik kondansatör |  | kontrol edilecek |  | THT disk seramik, 5 mm adım | C2, C5, C6 bypass / VREF filtreleme | Pasif
EMG Sensör | 10 µF elektrolitik kondansatör |  | kontrol edilecek |  | Radial THT, polariteye dikkat | C3 VREF filtreleme | Pasif
EMG Sensör | 2.2 µF film/polyester kondansatör |  | kontrol edilecek |  | 5 mm adım, non-polar; elektrolitik kullanılmamalı | C4 yüksek geçiren filtre | Pasif
EMG Sensör | 330 nF kondansatör |  | kontrol edilecek |  | THT seramik veya film, 5 mm adım | Cf2 RAW_Out alçak geçiren filtre | Pasif
EMG Sensör | 1x3 pin header |  | kontrol edilecek |  | 2.54 mm dikey THT | J1 elektrot girişi | Konnektör
EMG Sensör | 1x4 pin header |  | kontrol edilecek |  | 2.54 mm dikey THT | J2 besleme ve çıkış | Konnektör

Sheet: Notlar
Başlık | Not
Kaynak proje | EMG_v2_working_package_FIXED
Parça sayımı | Bileşenler şemadaki son FIXED değerlere göre listelendi.
Stok/Fiyat | Pasif parçalar için kesin stok/fiyat yazılmadı; tedarik sırasında kontrol edilmeli.
C4 notu | C4 için 2.2 µF film/polyester veya uygun non-polar kondansatör kullanılmalı.
Güvenlik | Hasta/elektrot tarafı koruma devresi hala eksik; insan üzerinde kullanımda dikkat edilmeli.
Gerber | Üretim öncesi FIXED KiCad projesinden Gerber yeniden export edilmeli.
Çıkış | RAW_Out analog ADC/osiloskop çıkışıdır.
