Batuhxn/EMG/V5/ESP32 H2 Supermini.step

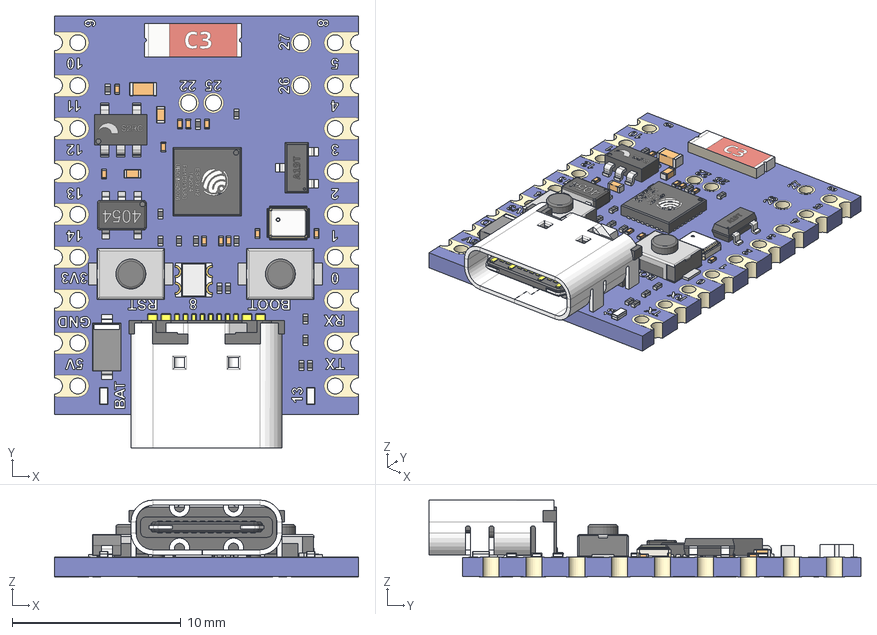
[picture p1: CAD file, 2026-07-01]
V5/ESP32 H2 Supermini.step
18.0 x 25.6 x 4.54 mm
USB_type_C_smd_12p
SMD Ceramic Antenna
Light x 2
Cathode Mark x 2
Anode Pin x 2
Cathode Pin x 2
Base x 2
3x4x2mm - 2 button x 2
WS2812-2020
Yageo-RC0201 x 14
Cathode
Anode
Cathode Bar
2520 SMD Crystal Oscillator
TP4054-SOT23 v2
ME6211-SOT23 v2
Board
Top
Bottom
