Batuhxn/EMG/V5/EMG_v5.kicad_pcb

## KiCad design V5/EMG_v5.kicad_pcb (2026-08-07)

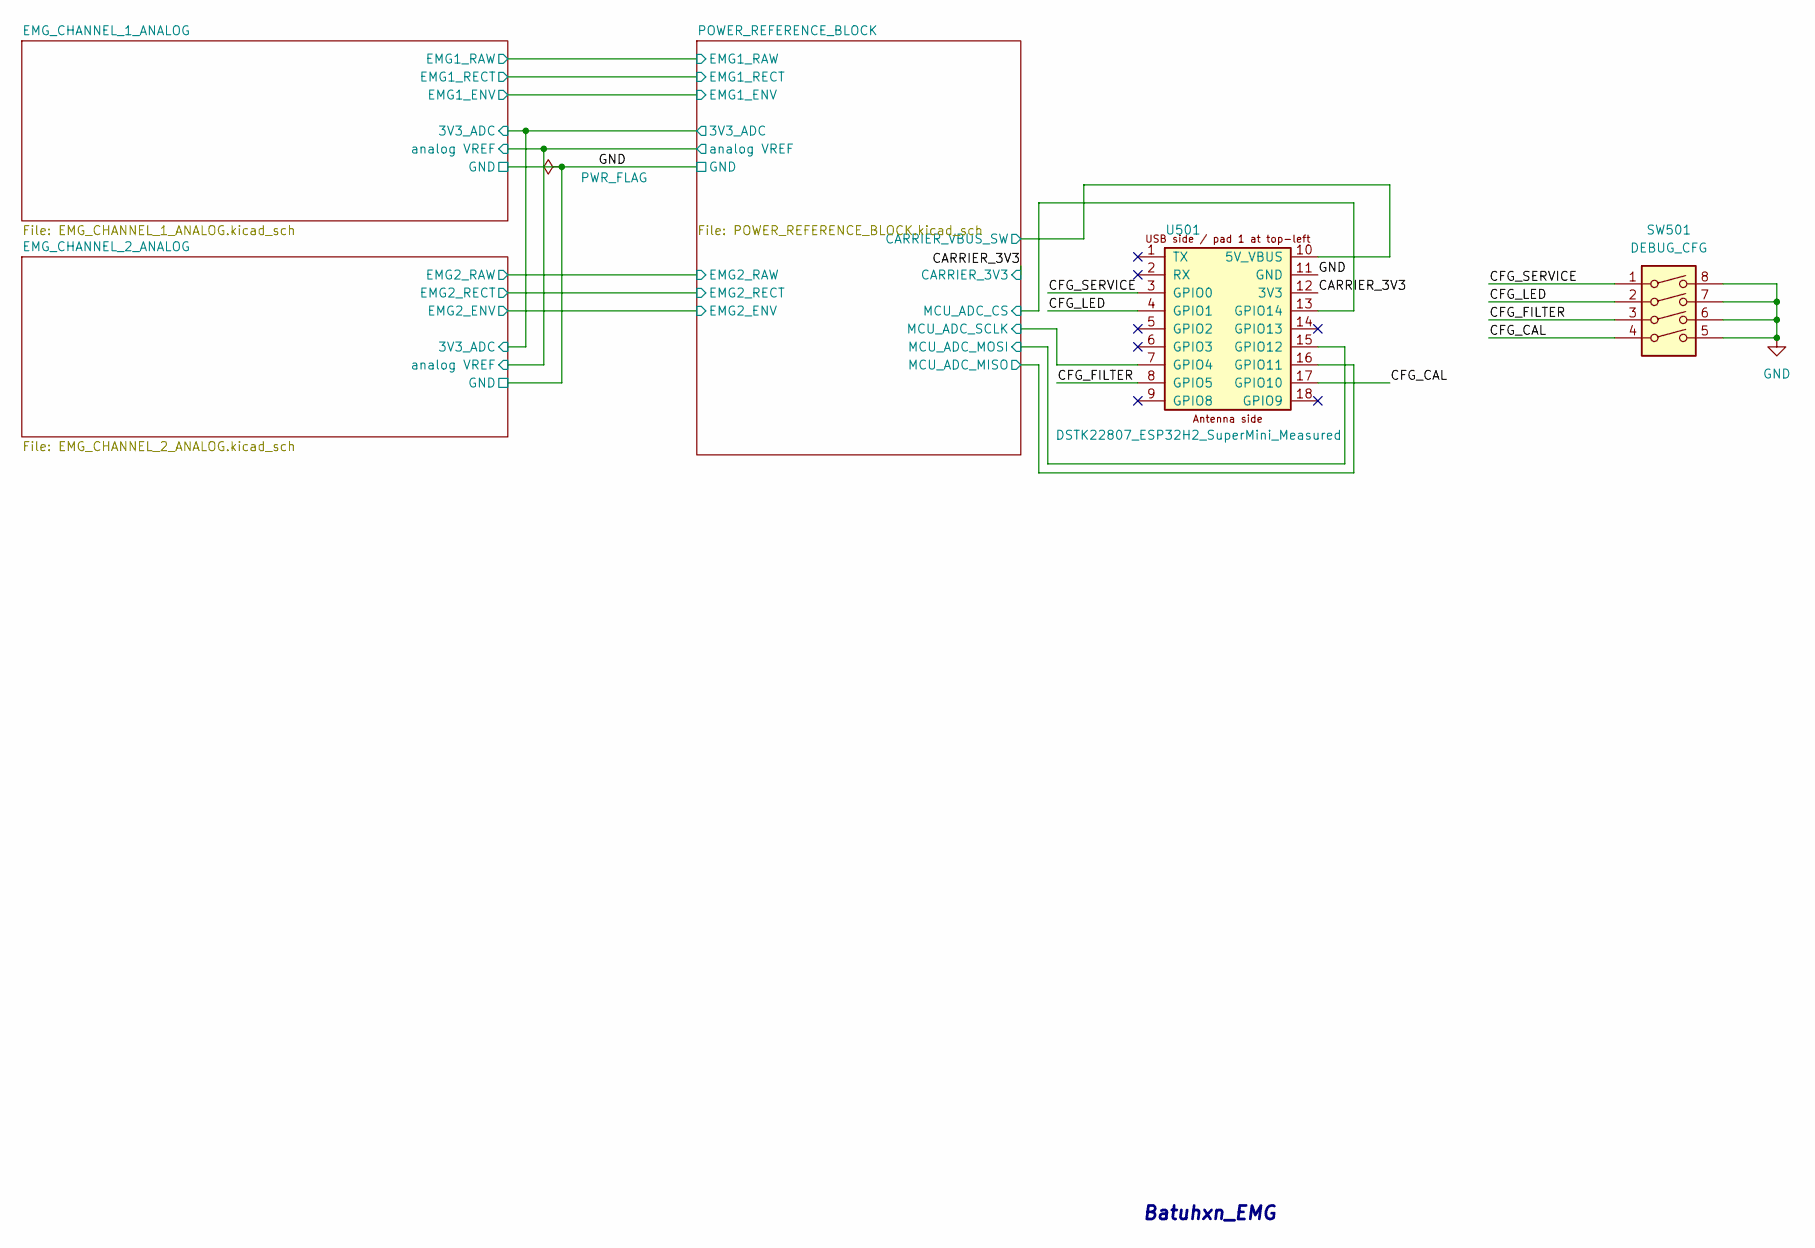
[picture p2: schematic EMG_v5.kicad_sch]

Parts:
SW501: DEBUG_CFG; SW_DIP_SPSTx04_Slide_9.78x12.34mm_W7.62mm_P2.54mm
U501: DSTK22807_ESP32H2_SuperMini_Measured; DSTK22807_ESP32H2_SuperMini_Carrier_Measured_THT

Connections:
/CARRIER_3V3: U501.12 (3V3); also elsewhere on the board
/CFG_CAL: SW501.4, U501.17 (GPIO10)
/CFG_FILTER: SW501.3, U501.8 (GPIO5)
/CFG_LED: SW501.2, U501.4 (GPIO1)
/CFG_SERVICE: SW501.1, U501.3 (GPIO0)
/POWER_REFERENCE_BLOCK/CARRIER_VBUS_SW: U501.10 (5V_VBUS); also elsewhere on the board
/POWER_REFERENCE_BLOCK/MCU_ADC_CS: U501.13 (GPIO14); also elsewhere on the board
/POWER_REFERENCE_BLOCK/MCU_ADC_MISO: U501.16 (GPIO11); also elsewhere on the board
/POWER_REFERENCE_BLOCK/MCU_ADC_MOSI: U501.15 (GPIO12); also elsewhere on the board
/POWER_REFERENCE_BLOCK/MCU_ADC_SCLK: U501.7 (GPIO4); also elsewhere on the board
GND: SW501.5, SW501.6, SW501.7, SW501.8, U501.11 (GND); also elsewhere on the board

Notes on the sheet:
Batuhxn_EMG

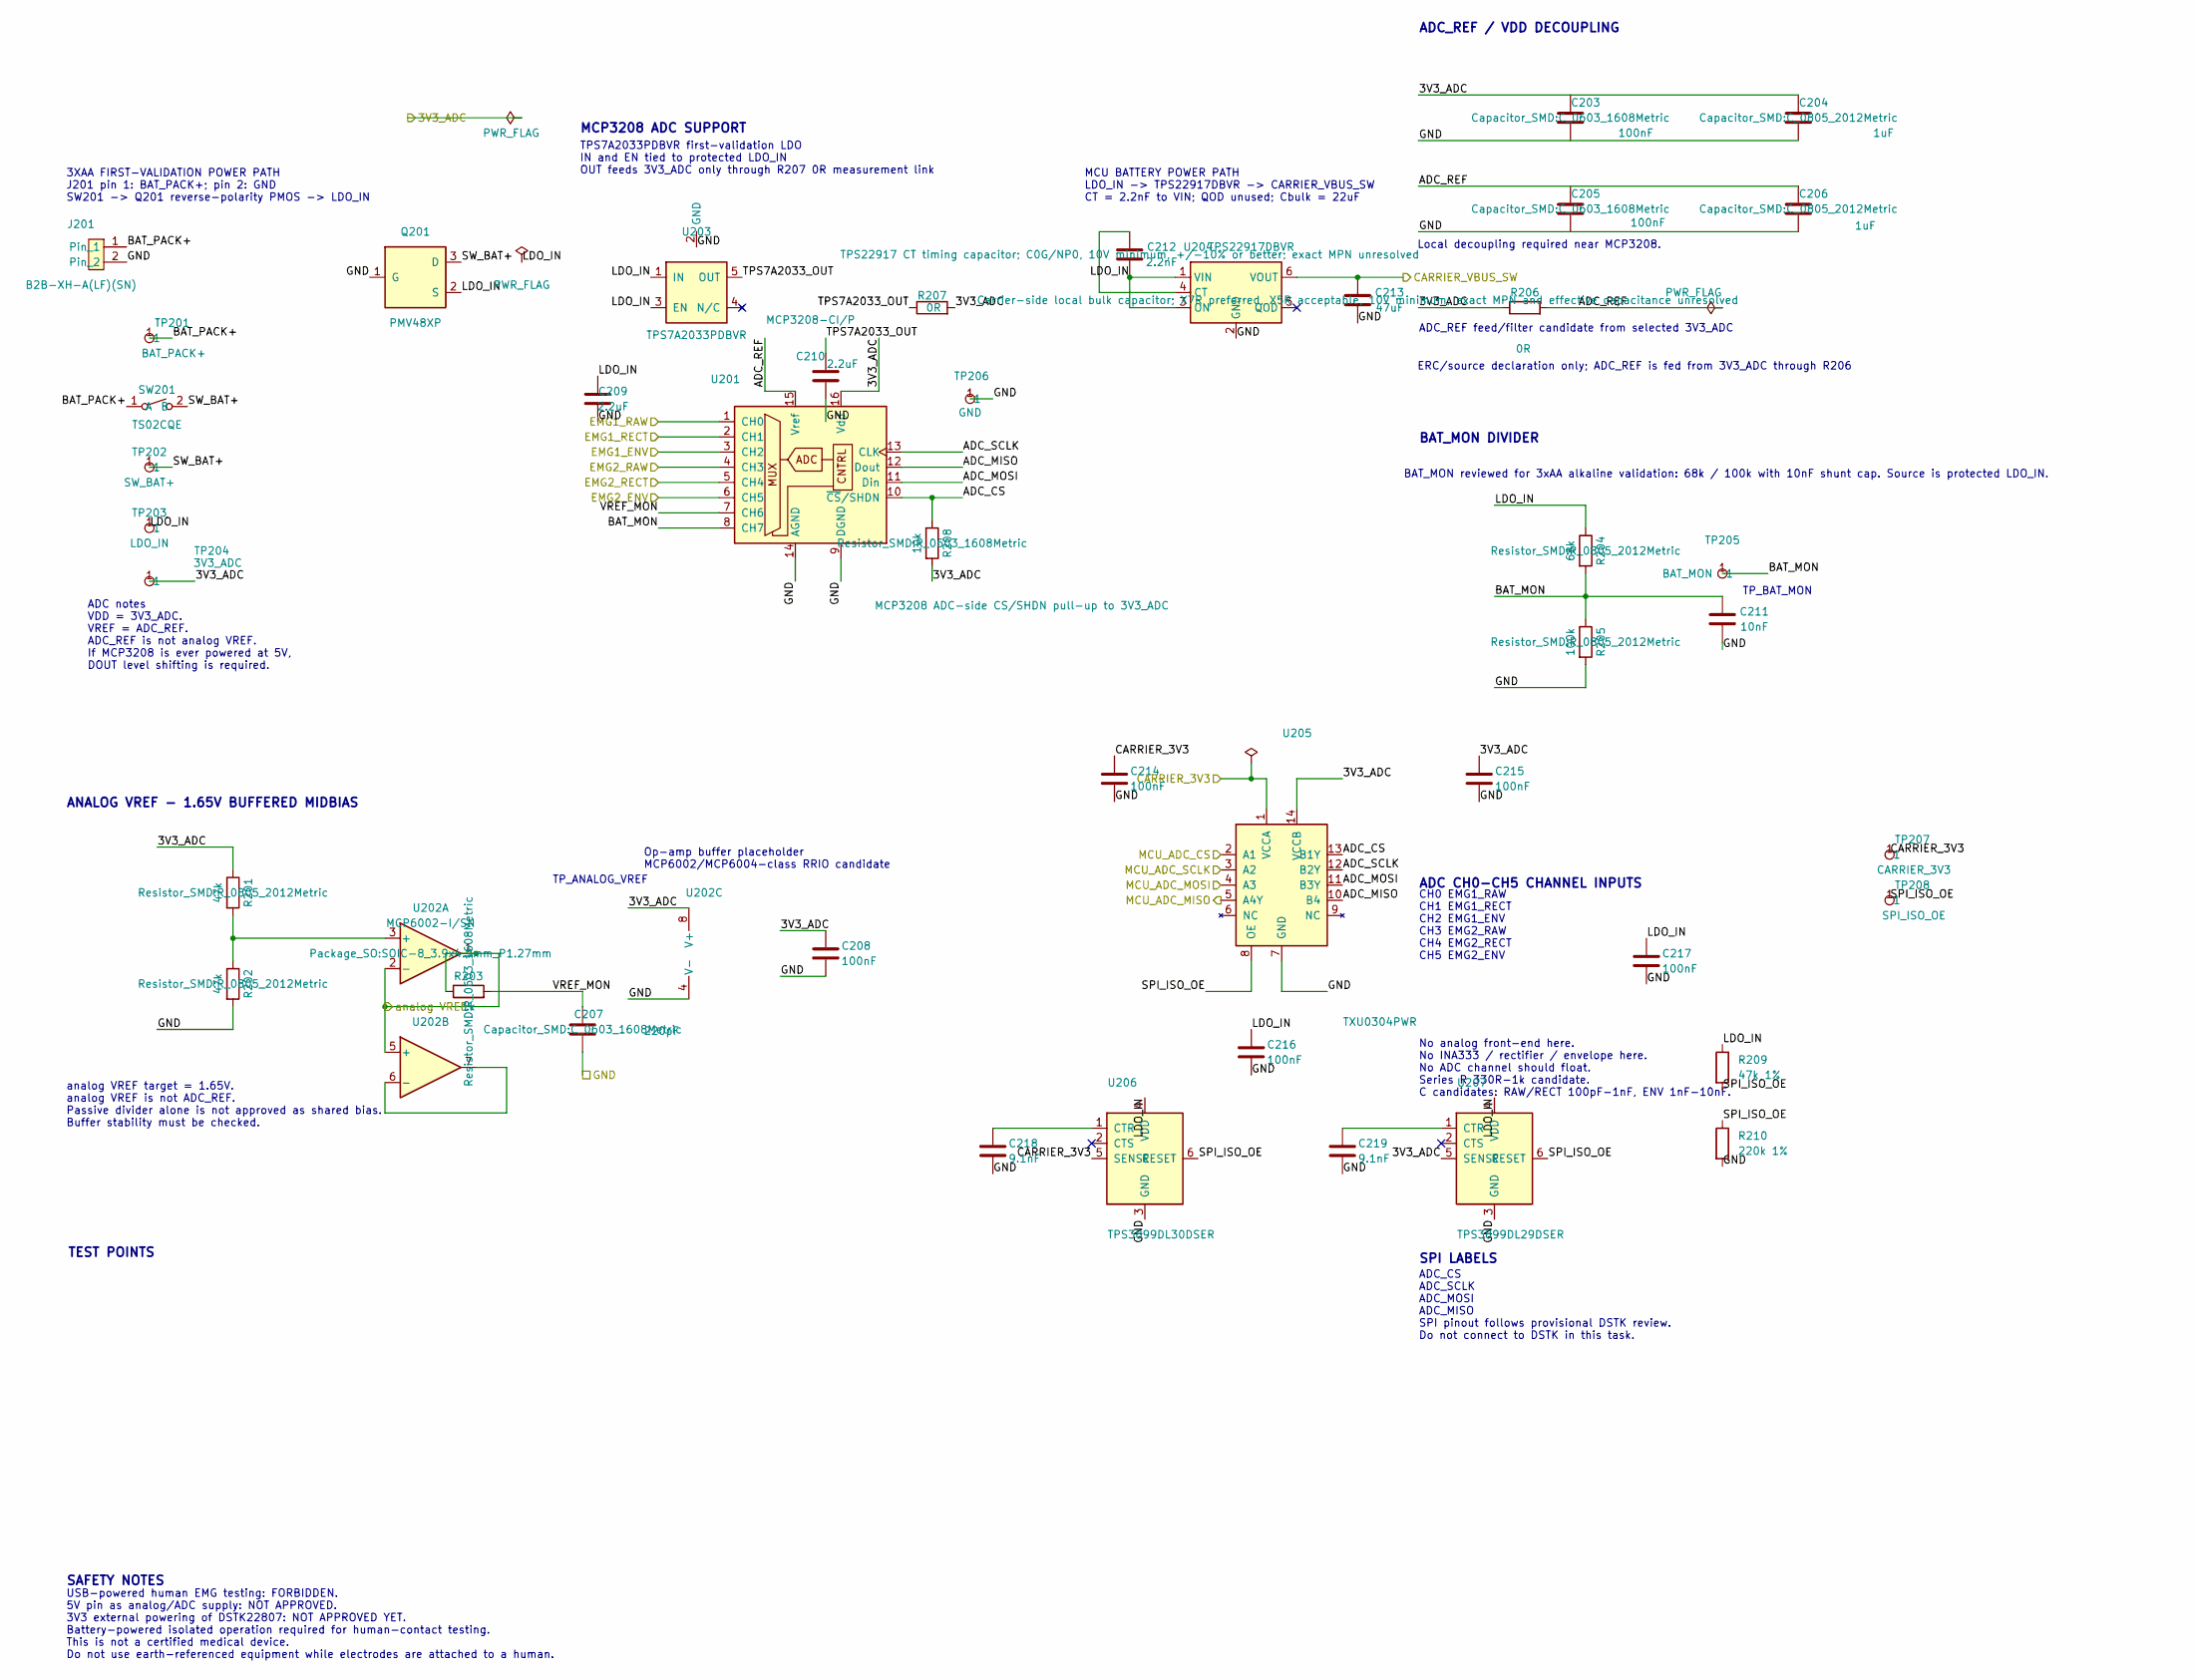
[picture p3: schematic POWER_REFERENCE_BLOCK.kicad_sch]

Parts:
C203, C205, C208, C214, C215, C216, C217: 100nF; C_0603_1608Metric
C204, C206: 1uF; C_0805_2012Metric
C207: 220pF; C_0603_1608Metric
C209, C210: 2.2uF; C_0805_2012Metric
C211: 10nF; C_0603_1608Metric
C212: 2.2nF; C_0603_1608Metric
C213: 47uF; C_1210_3225_Murata_GRM32_Reflow
C218, C219: 9.1nF; C_0603_1608Metric
J201: B2B-XH-A(LF)(SN); JST_XH_B2B-XH-A_1x02_P2.50mm_Vertical
Q201: PMV48XP; SOT-23
R201, R202: 47k; R_0805_2012Metric
R203: 1k; R_0603_1608Metric
R204: 68k; R_0805_2012Metric
R205: 100k; R_0805_2012Metric
R206, R207: 0R; R_0603_1608Metric
R208: 10k; R_0603_1608Metric
R209: 47k 1%; R_0603_1608Metric
R210: 220k 1%; R_0603_1608Metric
SW201: TS02CQE; TS02CQE_SPST_THT
TP201: BAT_PACK+; TestPoint_Pad_D1.0mm
TP202: SW_BAT+; TestPoint_Pad_D1.0mm
TP203: LDO_IN; TestPoint_Pad_D1.0mm
TP204: 3V3_ADC; TestPoint_Pad_D1.0mm
TP205: BAT_MON; TestPoint_Pad_D1.0mm
TP206: GND; TestPoint_Pad_D1.0mm
TP207: CARRIER_3V3; TestPoint_Pad_D1.0mm
TP208: SPI_ISO_OE; TestPoint_Pad_D1.0mm
U201: MCP3208-CI/P; DIP-16_W7.62mm
U202: MCP6002-I/SN; SOIC-8_3.9x4.9mm_P1.27mm
U203: TPS7A2033PDBVR; SOT-23-5
U204: TPS22917DBVR; SOT-23-6
U205: TXU0304PWR; TSSOP-14_4.4x5mm_P0.65mm
U206: TPS3899DL30DSER; WSON-6_1.5x1.5mm_P0.5mm
U207: TPS3899DL29DSER; WSON-6_1.5x1.5mm_P0.5mm

Connections:
/CARRIER_3V3: C214.1, TP207.1 (1_1), U205.1 (VCCA), U206.5 (SENSE); also elsewhere on the board
/EMG_CHANNEL_1_ANALOG/3V3_ADC: C203.1, C204.1, C208.1, C215.1, R201.1, R206.1, R207.2, R208.2, TP204.1 (1_1), U201.16 (Vdd), U202.8 (V+), U205.14 (VCCB), U207.5 (SENSE); also elsewhere on the board
/EMG_CHANNEL_1_ANALOG/EMG1_ENV: U201.3 (CH2); also elsewhere on the board
/EMG_CHANNEL_1_ANALOG/EMG1_RAW: U201.1 (CH0); also elsewhere on the board
/EMG_CHANNEL_1_ANALOG/EMG1_RECT: U201.2 (CH1); also elsewhere on the board
/EMG_CHANNEL_1_ANALOG/analog VREF: R203.1, U202.1, U202.2 (-), U202.5 (+); also elsewhere on the board
/EMG_CHANNEL_2_ANALOG/EMG2_ENV: U201.6 (CH5); also elsewhere on the board
/EMG_CHANNEL_2_ANALOG/EMG2_RAW: U201.4 (CH3); also elsewhere on the board
/EMG_CHANNEL_2_ANALOG/EMG2_RECT: U201.5 (CH4); also elsewhere on the board
/POWER_REFERENCE_BLOCK/ADC_CS: R208.1, U201.10 (~CS/SHDN), U205.13 (B1Y)
/POWER_REFERENCE_BLOCK/ADC_MISO: U201.12 (Dout), U205.10 (B4)
/POWER_REFERENCE_BLOCK/ADC_MOSI: U201.11 (Din), U205.11 (B3Y)
/POWER_REFERENCE_BLOCK/ADC_REF: C205.1, C206.1, R206.2, U201.15 (Vref)
/POWER_REFERENCE_BLOCK/ADC_SCLK: U201.13 (CLK), U205.12 (B2Y)
/POWER_REFERENCE_BLOCK/BAT_MON: C211.1, R204.2, R205.1, TP205.1 (1_1), U201.8 (CH7)
/POWER_REFERENCE_BLOCK/BAT_PACK+: J201.1, SW201.1 (A), TP201.1 (1_1)
/POWER_REFERENCE_BLOCK/CARRIER_VBUS_SW: C213.1, U204.6 (VOUT); also elsewhere on the board
/POWER_REFERENCE_BLOCK/LDO_IN: C209.1, C212.2, C216.1, C217.1, Q201.2 (S), R204.1, R209.1, TP203.1 (1_1), U203.1 (IN), U203.3 (EN), U204.1 (VIN), U204.3 (ON), U206.4 (VDD), U207.4 (VDD)
/POWER_REFERENCE_BLOCK/MCU_ADC_CS: U205.2 (A1); also elsewhere on the board
/POWER_REFERENCE_BLOCK/MCU_ADC_MISO: U205.5 (A4Y); also elsewhere on the board
/POWER_REFERENCE_BLOCK/MCU_ADC_MOSI: U205.4 (A3); also elsewhere on the board
/POWER_REFERENCE_BLOCK/MCU_ADC_SCLK: U205.3 (A2); also elsewhere on the board
/POWER_REFERENCE_BLOCK/SPI_ISO_OE: R209.2, R210.1, TP208.1 (1_1), U205.8 (OE), U206.6 (RESET), U207.6 (RESET)
/POWER_REFERENCE_BLOCK/SW_BAT+: Q201.3 (D), SW201.2 (B), TP202.1 (1_1)
/POWER_REFERENCE_BLOCK/TPS7A2033_OUT: C210.1, R207.1, U203.5 (OUT)
/POWER_REFERENCE_BLOCK/VREF_MON: C207.1, R203.2, U201.7 (CH6)
GND: C203.2, C204.2, C205.2, C206.2, C207.2, C208.2, C209.2, C210.2, C211.2, C213.2, C214.2, C215.2, C216.2, C217.2, C218.2, C219.2, J201.2, Q201.1 (G), R202.2, R205.2, R210.2, TP206.1 (1_1), U201.9 (DGND), U201.14 (AGND), U202.4 (V-), U203.2 (GND), U204.2 (GND), U205.7 (GND), U206.3 (GND), U207.3 (GND); also elsewhere on the board
unnamed: R201.2, R202.1, U202.3 (+)
unnamed: U202.6 (-), U202.7
unnamed: C212.1, U204.4 (CT)
unnamed: C218.1, U206.1 (CTR)
unnamed: C219.1, U207.1 (CTR)

Notes on the sheet:
MCP3208 ADC SUPPORT
ADC notes VDD = 3V3_ADC. VREF = ADC_REF. ADC_REF is not analog VREF. If MCP3208 is ever powered at 5V, DOUT level shifting is required.
ADC_REF / VDD DECOUPLING
Local decoupling required near MCP3208.
ANALOG VREF - 1.65V BUFFERED MIDBIAS
analog VREF target = 1.65V. analog VREF is not ADC_REF. Passive divider alone is not approved as shared bias. Buffer stability must be checked.
TP_ANALOG_VREF
Op-amp buffer placeholder MCP6002/MCP6004-class RRIO candidate
BAT_MON DIVIDER
TP_BAT_MON
ADC CH0-CH5 CHANNEL INPUTS
CH0 EMG1_RAW CH1 EMG1_RECT CH2 EMG1_ENV CH3 EMG2_RAW CH4 EMG2_RECT CH5 EMG2_ENV
No analog front-end here. No INA333 / rectifier / envelope here. No ADC channel should float. Series R 330R-1k candidate. C candidates: RAW/RECT 100pF-1nF, ENV 1nF-10nF.
SPI LABELS
ADC_CS ADC_SCLK ADC_MOSI ADC_MISO SPI pinout follows provisional DSTK review. Do not connect to DSTK in this task.
TEST POINTS
SAFETY NOTES
USB-powered human EMG testing: FORBIDDEN. 5V pin as analog/ADC supply: NOT APPROVED. 3V3 external powering of DSTK22807: NOT APPROVED YET. Battery-powered isolated operation required for human-contact testing. This is not a certified medical device. Do not use earth-referenced equipment while elect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
ADC_REF feed/filter candidate from selected 3V3_ADC
ERC/source declaration only; ADC_REF is fed from 3V3_ADC through R206
3XAA FIRST-VALIDATION POWER PATH J201 pin 1: BAT_PACK+; pin 2: GND SW201 -> Q201 reverse-polarity PMOS -> LDO_IN
TPS7A2033PDBVR first-validation LDO IN and EN tied to protected LDO_IN OUT feeds 3V3_ADC only through R207 0R measurement link
BAT_MON reviewed for 3xAA alkaline validation: 68k / 100k with 10nF shunt cap. Source is protected LDO_IN.
MCU BATTERY POWER PATH LDO_IN -> TPS22917DBVR -> CARRIER_VBUS_SW CT = 2.2nF to VIN; QOD unused; Cbulk = 22uF

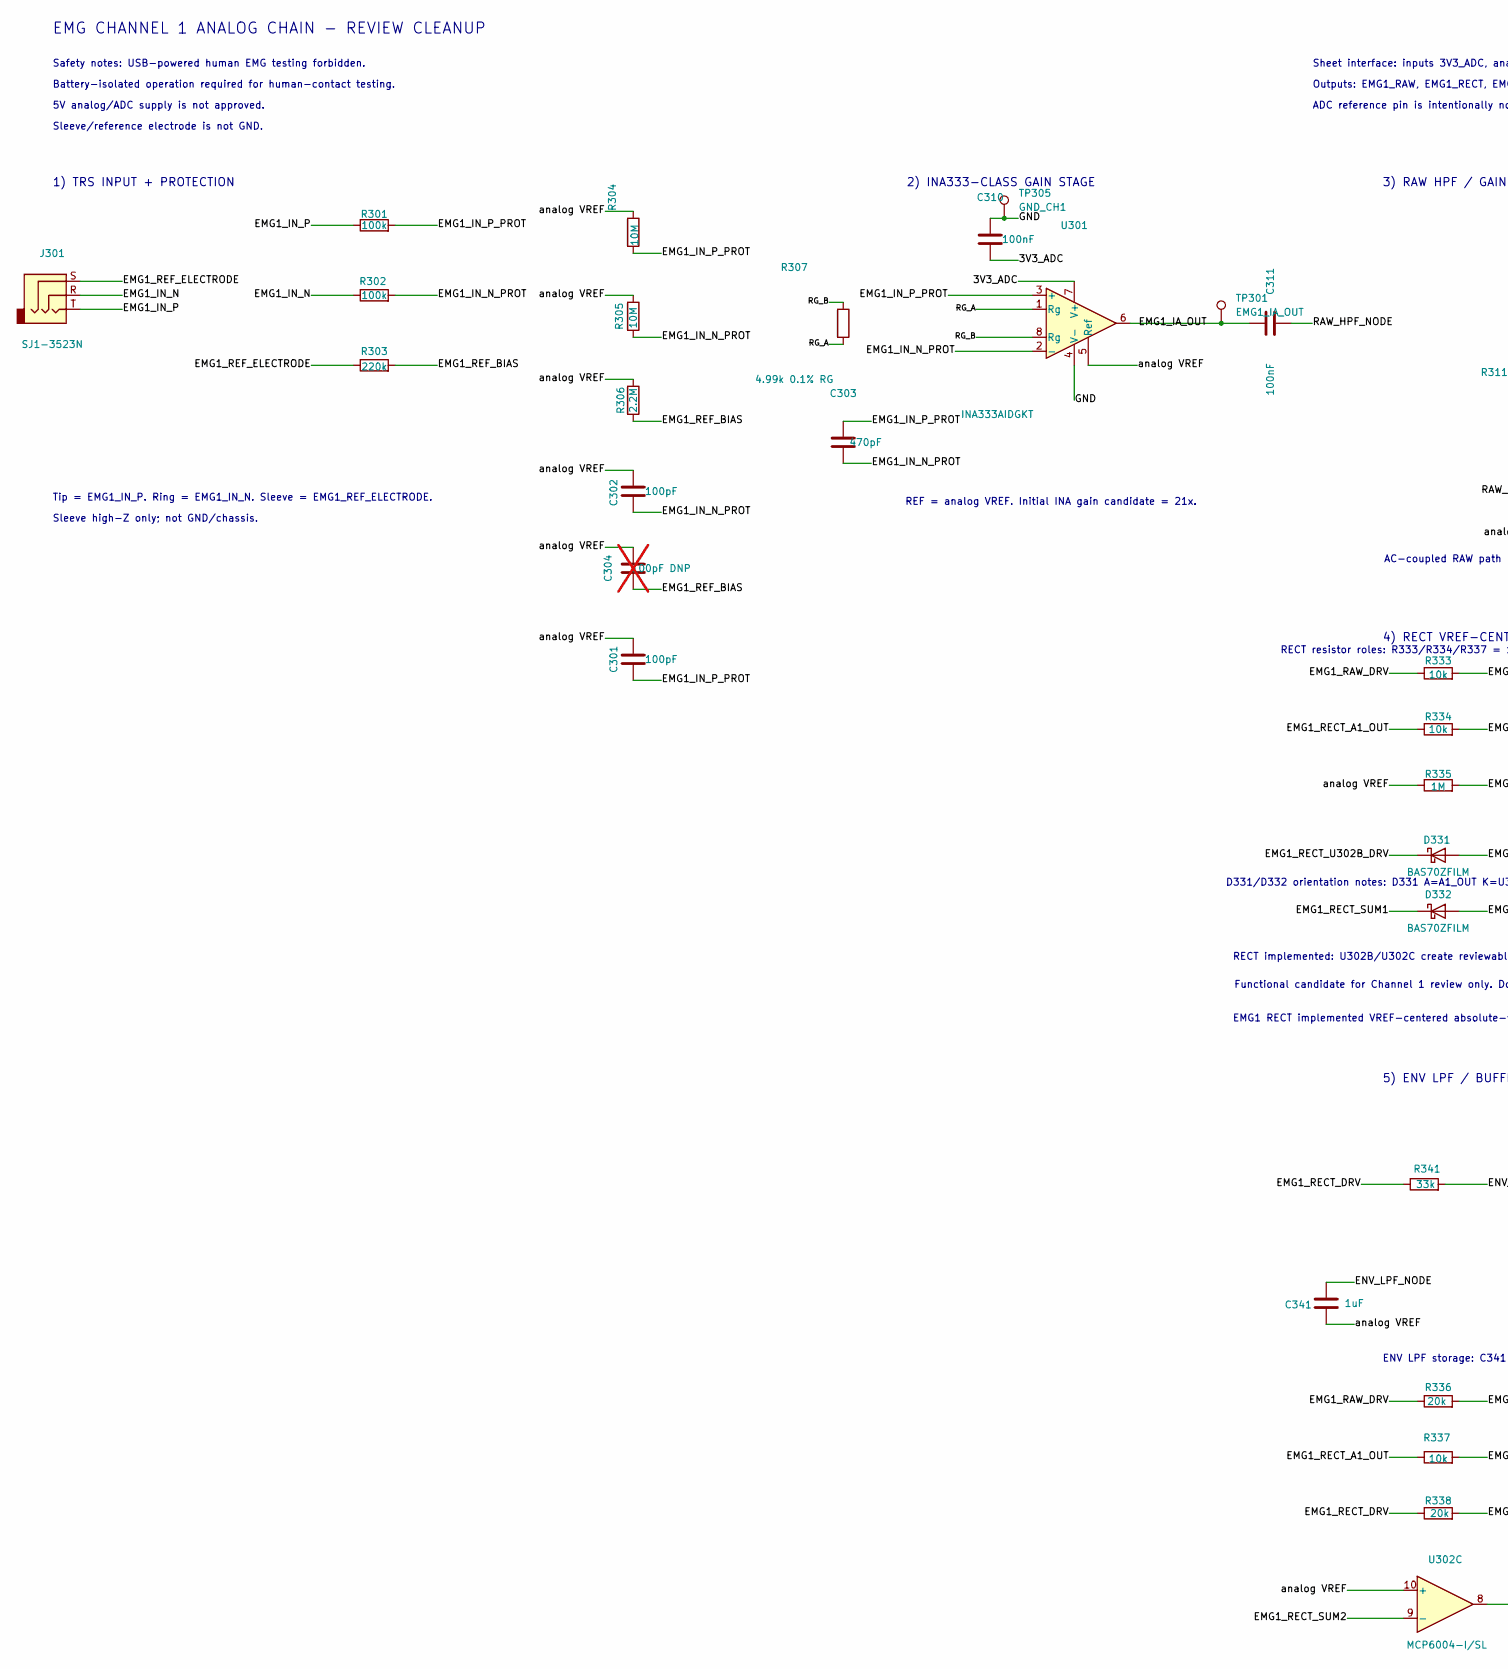
[picture p4: schematic EMG_CHANNEL_1_ANALOG.kicad_sch, part in row 1, column 1]

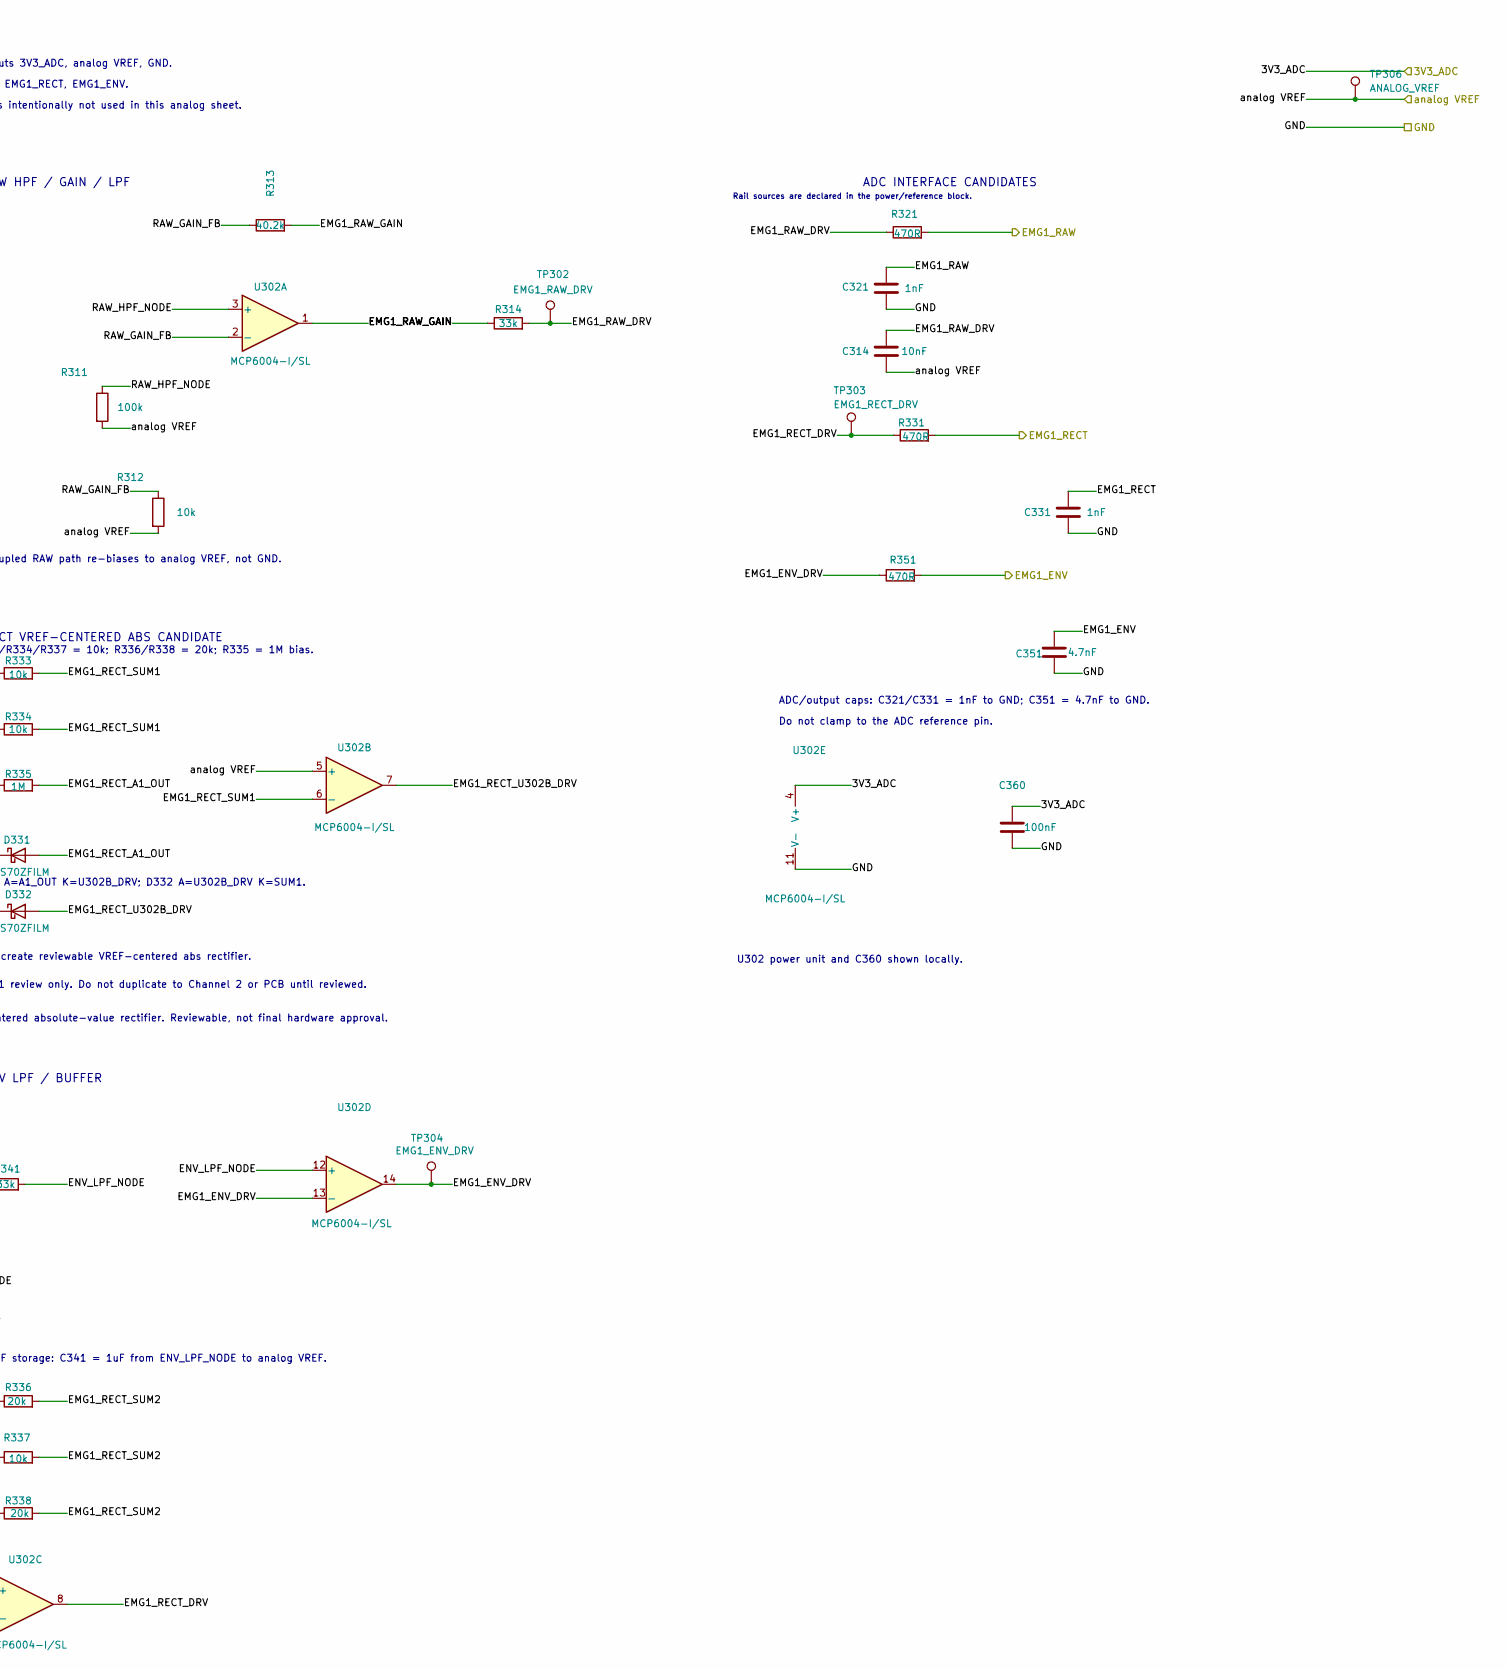
[picture p5: schematic EMG_CHANNEL_1_ANALOG.kicad_sch, part in row 1, column 2]

Parts:
C301, C302: 100pF; C_0603_1608Metric
C303: 470pF; C_0603_1608Metric
C304: 100pF DNP; C_0603_1608Metric; not fitted
C310, C311: 100nF; C_0603_1608Metric
C314: 10nF; C_0603_1608Metric
C321, C331: 1nF; C_0805_2012Metric
C341: 1uF; C_0805_2012Metric
C351: 4.7nF; C_0805_2012Metric
C360: 100nF; C_0805_2012Metric
D331, D332: BAS70ZFILM; D_SOD-123
J301: SJ1-3523N; Jack_3.5mm_CUI_SJ1-3523N_Horizontal
R301, R302: 100k; R_1206_3216Metric
R303: 220k; R_1206_3216Metric
R304, R305: 10M; R_1206_3216Metric
R306: 2.2M; R_1206_3216Metric
R307: 4.99k 0.1% RG; R_0805_2012Metric
R311: 100k; R_0805_2012Metric
R312, R333, R334, R337: 10k; R_0805_2012Metric
R313: 40.2k; R_0805_2012Metric
R314, R341: 33k; R_0805_2012Metric
R321, R331, R351: 470R; R_0805_2012Metric
R335: 1M; R_0805_2012Metric
R336, R338: 20k; R_0805_2012Metric
TP301: EMG1_IA_OUT; TestPoint_Pad_D1.5mm
TP302: EMG1_RAW_DRV; TestPoint_Pad_D1.5mm
TP303: EMG1_RECT_DRV; TestPoint_Pad_D1.5mm
TP304: EMG1_ENV_DRV; TestPoint_Pad_D1.5mm
TP305: GND_CH1; TestPoint_Pad_D2.0mm
TP306: ANALOG_VREF; TestPoint_Pad_D1.5mm
U301: INA333AIDGKT; INA333_DGK_VSSOP-8_TI
U302: MCP6004-I/SL; SOIC-14_3.9x8.7mm_P1.27mm

Connections:
/EMG_CHANNEL_1_ANALOG/3V3_ADC: C310.2, C360.1, U301.7 (V+), U302.4 (V+); also elsewhere on the board
/EMG_CHANNEL_1_ANALOG/EMG1_ENV: C351.1, R351.2; also elsewhere on the board
/EMG_CHANNEL_1_ANALOG/EMG1_ENV_DRV: R351.1, TP304.1 (1_1), U302.13 (-), U302.14
/EMG_CHANNEL_1_ANALOG/EMG1_IA_OUT: C311.1, TP301.1 (1_1), U301.6
/EMG_CHANNEL_1_ANALOG/EMG1_IN_N: J301.R, R302.1
/EMG_CHANNEL_1_ANALOG/EMG1_IN_N_PROT: C302.2, C303.2, R302.2, R305.2, U301.2 (-)
/EMG_CHANNEL_1_ANALOG/EMG1_IN_P: J301.T, R301.1
/EMG_CHANNEL_1_ANALOG/EMG1_IN_P_PROT: C301.2, C303.1, R301.2, R304.2, U301.3 (+)
/EMG_CHANNEL_1_ANALOG/EMG1_RAW: C321.1, R321.2; also elsewhere on the board
/EMG_CHANNEL_1_ANALOG/EMG1_RAW_DRV: C314.1, R314.2, R321.1, R333.1, R336.1, TP302.1 (1_1)
/EMG_CHANNEL_1_ANALOG/EMG1_RAW_GAIN: R313.2, R314.1, U302.1
/EMG_CHANNEL_1_ANALOG/EMG1_RECT: C331.1, R331.2; also elsewhere on the board
/EMG_CHANNEL_1_ANALOG/EMG1_RECT_A1_OUT: D331.2 (A), R334.1, R335.2, R337.1
/EMG_CHANNEL_1_ANALOG/EMG1_RECT_DRV: R331.1, R338.1, R341.1, TP303.1 (1_1), U302.8
/EMG_CHANNEL_1_ANALOG/EMG1_RECT_SUM1: D332.1 (K), R333.2, R334.2, U302.6 (-)
/EMG_CHANNEL_1_ANALOG/EMG1_RECT_SUM2: R336.2, R337.2, R338.2, U302.9 (-)
/EMG_CHANNEL_1_ANALOG/EMG1_RECT_U302B_DRV: D331.1 (K), D332.2 (A), U302.7
/EMG_CHANNEL_1_ANALOG/EMG1_REF_BIAS: C304.2, R303.2, R306.2
/EMG_CHANNEL_1_ANALOG/EMG1_REF_ELECTRODE: J301.S, R303.1
/EMG_CHANNEL_1_ANALOG/ENV_LPF_NODE: C341.1, R341.2, U302.12 (+)
/EMG_CHANNEL_1_ANALOG/RAW_GAIN_FB: R312.1, R313.1, U302.2 (-)
/EMG_CHANNEL_1_ANALOG/RAW_HPF_NODE: C311.2, R311.1, U302.3 (+)
/EMG_CHANNEL_1_ANALOG/RG_A: R307.2, U301.1 (Rg)
/EMG_CHANNEL_1_ANALOG/RG_B: R307.1, U301.8 (Rg)
/EMG_CHANNEL_1_ANALOG/analog VREF: C301.1, C302.1, C304.1, C314.2, C341.2, R304.1, R305.1, R306.1, R311.2, R312.2, R335.1, TP306.1 (1_1), U301.5 (Ref), U302.5 (+), U302.10 (+); also elsewhere on the board
GND: C310.1, C321.2, C331.2, C351.2, C360.2, TP305.1 (1_1), U301.4 (V-), U302.11 (V-); also elsewhere on the board

Notes on the sheet:
EMG CHANNEL 1 ANALOG CHAIN - REVIEW CLEANUP
Safety notes: USB-powered human EMG testing forbidden.
Battery-isolated operation required for human-contact testing.
5V analog/ADC supply is not approved.
Sleeve/reference electrode is not GND.
Sheet interface: inputs 3V3_ADC, analog VREF, GND.
Outputs: EMG1_RAW, EMG1_RECT, EMG1_ENV.
ADC reference pin is intentionally not used in this analog sheet.
Rail sources are declared in the power/reference block.
1) TRS INPUT + PROTECTION
Tip = EMG1_IN_P. Ring = EMG1_IN_N. Sleeve = EMG1_REF_ELECTRODE.
Sleeve high-Z only; not GND/chassis.
2) INA333-CLASS GAIN STAGE
REF = analog VREF. Initial INA gain candidate = 21x.
3) RAW HPF / GAIN / LPF
AC-coupled RAW path re-biases to analog VREF, not GND.
4) RECT VREF-CENTERED ABS CANDIDATE
RECT implemented: U302B/U302C create reviewable VREF-centered abs rectifier.
Functional candidate for Channel 1 review only. Do not duplicate to Channel 2 or PCB until reviewed.
5) ENV LPF / BUFFER
ENV LPF storage: C341 = 1uF from ENV_LPF_NODE to analog VREF.
U302 power unit and C360 shown locally.
ADC INTERFACE CANDIDATES
ADC/output caps: C321/C331 = 1nF to GND; C351 = 4.7nF to GND.
Do not clamp to the ADC reference pin.
D331/D332 orientation notes: D331 A=A1_OUT K=U302B_DRV; D332 A=U302B_DRV K=SUM1.
RECT resistor roles: R333/R334/R337 = 10k; R336/R338 = 20k; R335 = 1M bias.
EMG1 RECT implemented VREF-centered absolute-value rectifier. Reviewable, not final hardware approval.
