Batuhxn/EMG/V5/EMG_v5.kicad_pcb

## KiCad design V5/EMG_v5.kicad_pcb (continued)

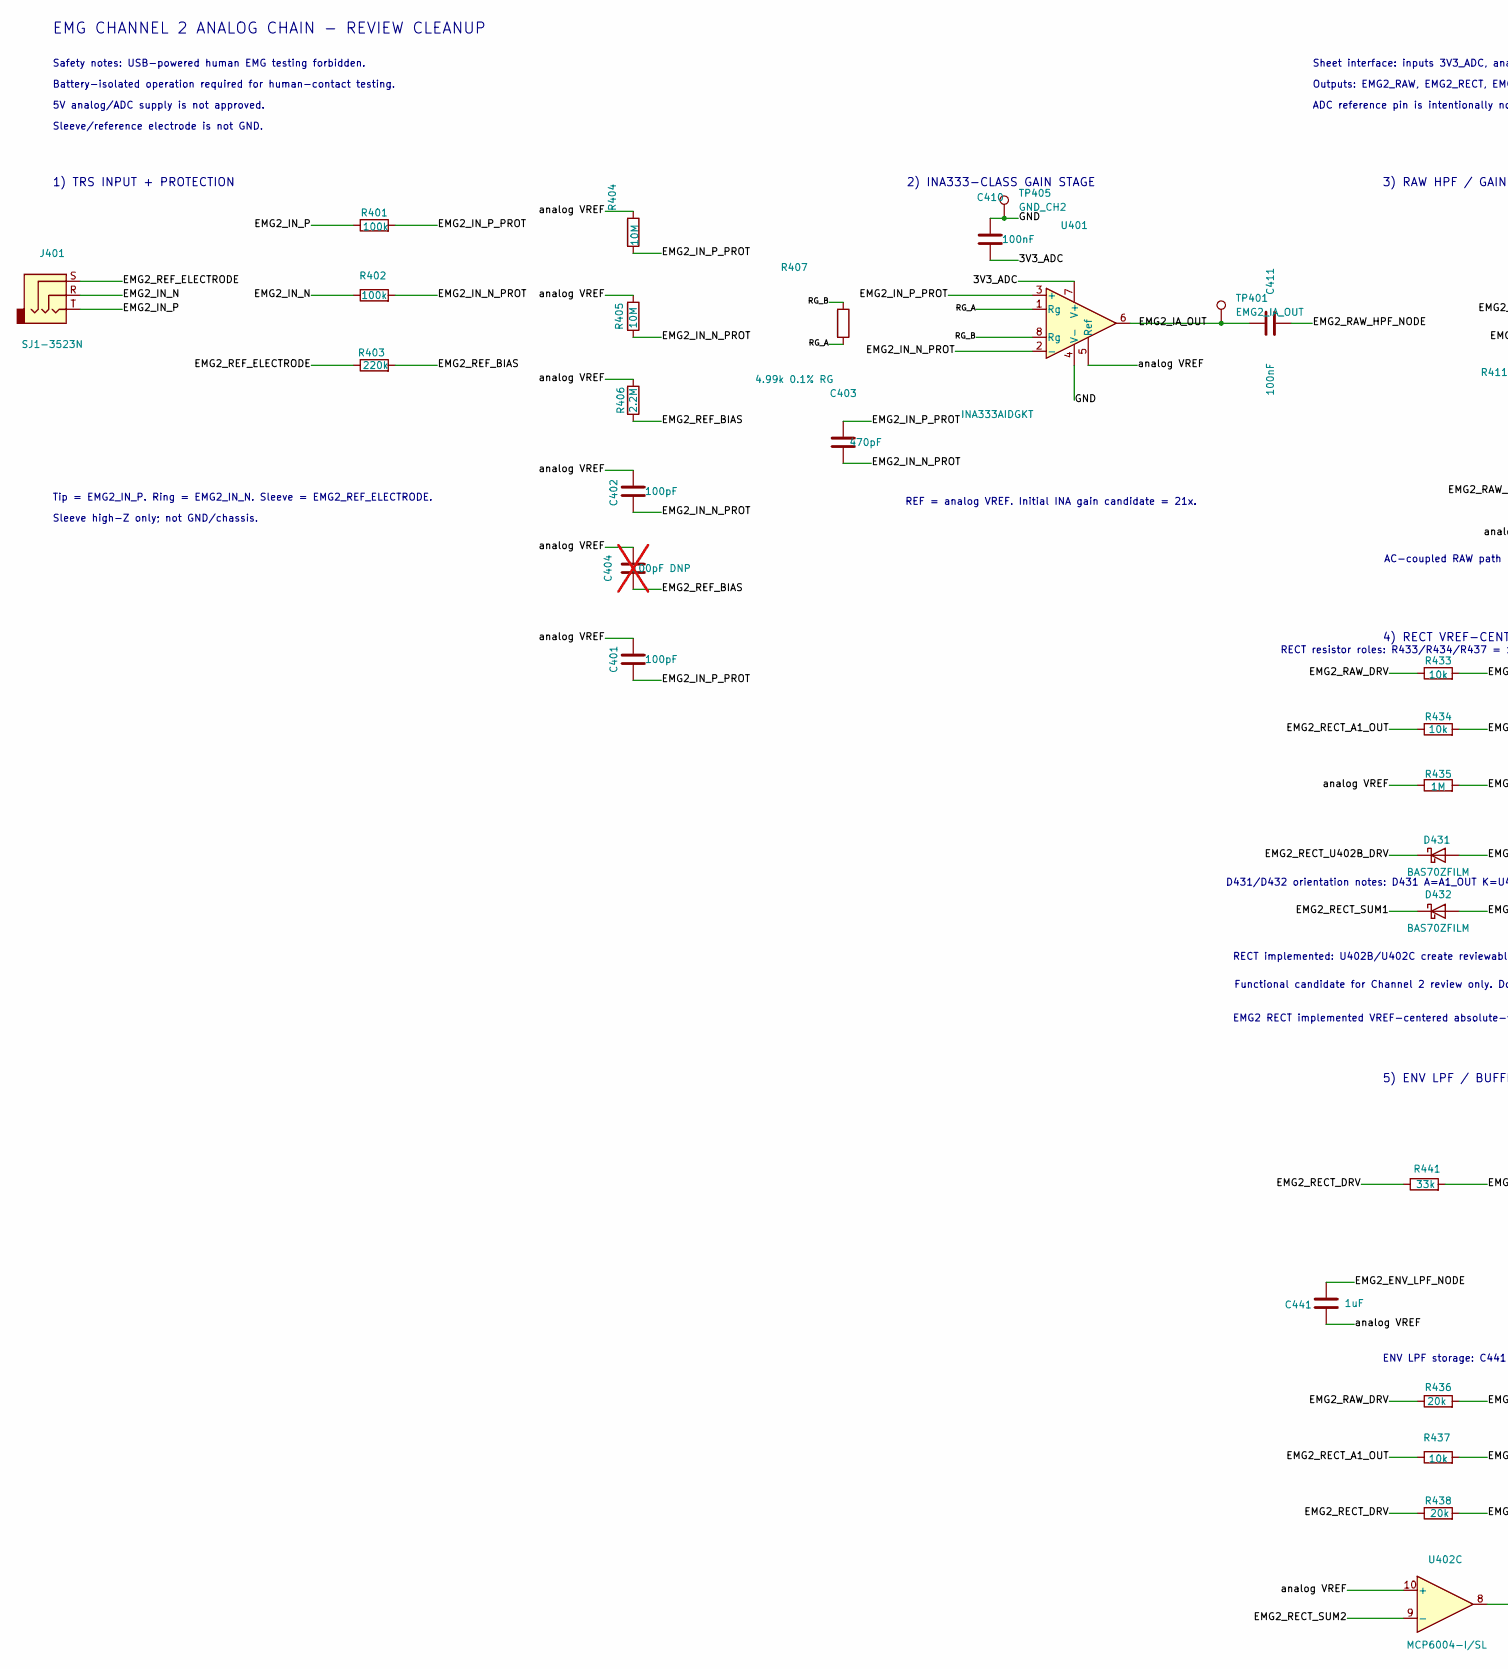
[picture p6: schematic EMG_CHANNEL_2_ANALOG.kicad_sch, part in row 1, column 1]

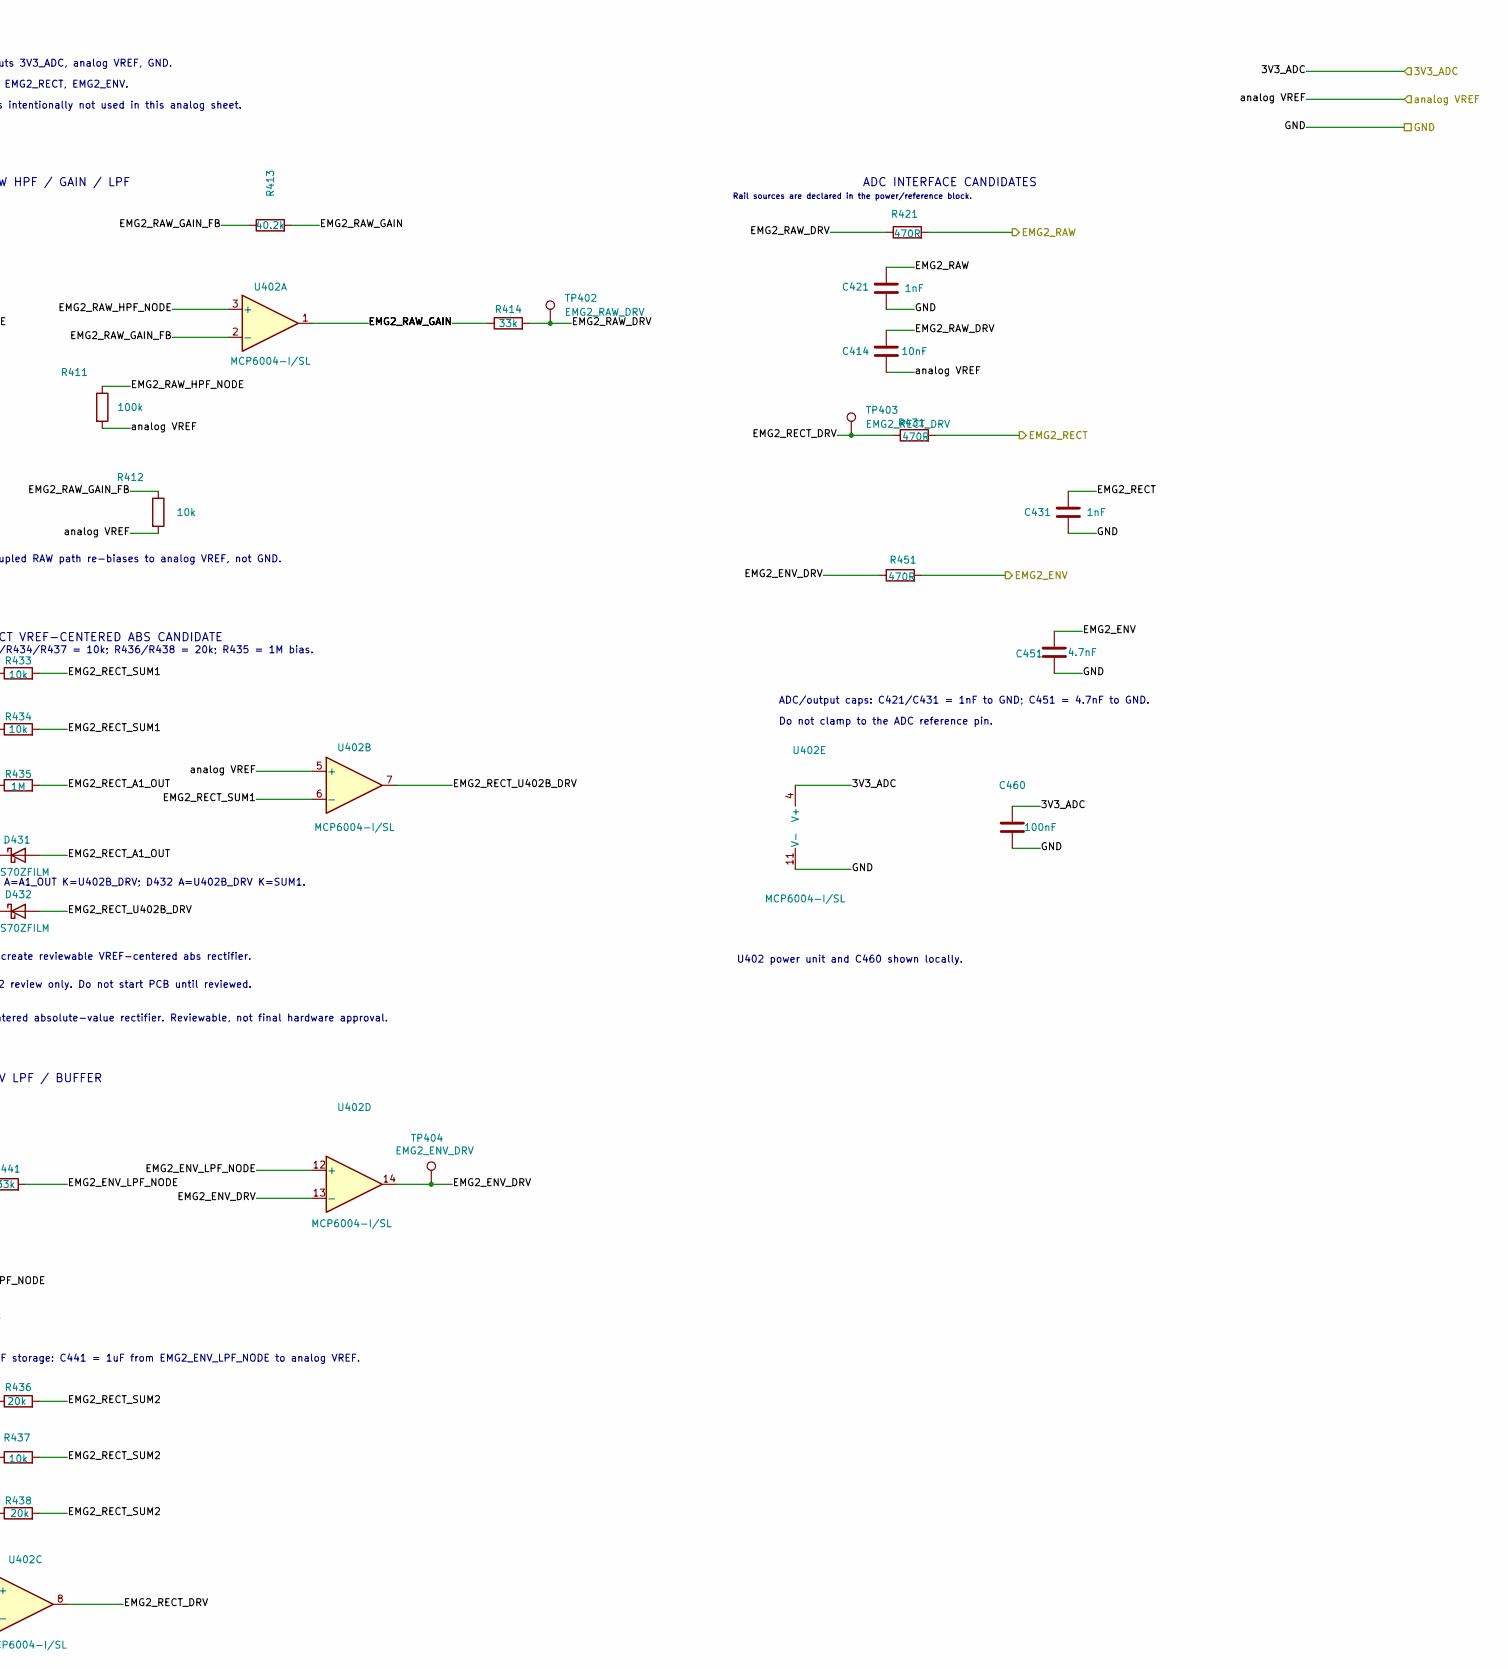
[picture p7: schematic EMG_CHANNEL_2_ANALOG.kicad_sch, part in row 1, column 2]

Parts:
C401, C402: 100pF; C_0603_1608Metric
C403: 470pF; C_0603_1608Metric
C404: 100pF DNP; C_0603_1608Metric; not fitted
C410, C411: 100nF; C_0603_1608Metric
C414: 10nF; C_0603_1608Metric
C421, C431: 1nF; C_0805_2012Metric
C441: 1uF; C_0805_2012Metric
C451: 4.7nF; C_0805_2012Metric
C460: 100nF; C_0805_2012Metric
D431, D432: BAS70ZFILM; D_SOD-123
J401: SJ1-3523N; Jack_3.5mm_CUI_SJ1-3523N_Horizontal
R401, R402: 100k; R_1206_3216Metric
R403: 220k; R_1206_3216Metric
R404, R405: 10M; R_1206_3216Metric
R406: 2.2M; R_1206_3216Metric
R407: 4.99k 0.1% RG; R_0805_2012Metric
R411: 100k; R_0805_2012Metric
R412, R433, R434, R437: 10k; R_0805_2012Metric
R413: 40.2k; R_0805_2012Metric
R414, R441: 33k; R_0805_2012Metric
R421, R431, R451: 470R; R_0805_2012Metric
R435: 1M; R_0805_2012Metric
R436, R438: 20k; R_0805_2012Metric
TP401: EMG2_IA_OUT; TestPoint_Pad_D1.5mm
TP402: EMG2_RAW_DRV; TestPoint_Pad_D1.5mm
TP403: EMG2_RECT_DRV; TestPoint_Pad_D1.5mm
TP404: EMG2_ENV_DRV; TestPoint_Pad_D1.5mm
TP405: GND_CH2; TestPoint_Pad_D2.0mm
U401: INA333AIDGKT; INA333_DGK_VSSOP-8_TI
U402: MCP6004-I/SL; SOIC-14_3.9x8.7mm_P1.27mm

Connections:
/EMG_CHANNEL_1_ANALOG/3V3_ADC: C410.2, C460.1, U401.7 (V+), U402.4 (V+); also elsewhere on the board
/EMG_CHANNEL_1_ANALOG/analog VREF: C401.1, C402.1, C404.1, C414.2, C441.2, R404.1, R405.1, R406.1, R411.2, R412.2, R435.1, U401.5 (Ref), U402.5 (+), U402.10 (+); also elsewhere on the board
/EMG_CHANNEL_2_ANALOG/EMG2_ENV: C451.1, R451.2; also elsewhere on the board
/EMG_CHANNEL_2_ANALOG/EMG2_ENV_DRV: R451.1, TP404.1 (1_1), U402.13 (-), U402.14
/EMG_CHANNEL_2_ANALOG/EMG2_ENV_LPF_NODE: C441.1, R441.2, U402.12 (+)
/EMG_CHANNEL_2_ANALOG/EMG2_IA_OUT: C411.1, TP401.1 (1_1), U401.6
/EMG_CHANNEL_2_ANALOG/EMG2_IN_N: J401.R, R402.1
/EMG_CHANNEL_2_ANALOG/EMG2_IN_N_PROT: C402.2, C403.2, R402.2, R405.2, U401.2 (-)
/EMG_CHANNEL_2_ANALOG/EMG2_IN_P: J401.T, R401.1
/EMG_CHANNEL_2_ANALOG/EMG2_IN_P_PROT: C401.2, C403.1, R401.2, R404.2, U401.3 (+)
/EMG_CHANNEL_2_ANALOG/EMG2_RAW: C421.1, R421.2; also elsewhere on the board
/EMG_CHANNEL_2_ANALOG/EMG2_RAW_DRV: C414.1, R414.2, R421.1, R433.1, R436.1, TP402.1 (1_1)
/EMG_CHANNEL_2_ANALOG/EMG2_RAW_GAIN: R413.2, R414.1, U402.1
/EMG_CHANNEL_2_ANALOG/EMG2_RAW_GAIN_FB: R412.1, R413.1, U402.2 (-)
/EMG_CHANNEL_2_ANALOG/EMG2_RAW_HPF_NODE: C411.2, R411.1, U402.3 (+)
/EMG_CHANNEL_2_ANALOG/EMG2_RECT: C431.1, R431.2; also elsewhere on the board
/EMG_CHANNEL_2_ANALOG/EMG2_RECT_A1_OUT: D431.2 (A), R434.1, R435.2, R437.1
/EMG_CHANNEL_2_ANALOG/EMG2_RECT_DRV: R431.1, R438.1, R441.1, TP403.1 (1_1), U402.8
/EMG_CHANNEL_2_ANALOG/EMG2_RECT_SUM1: D432.1 (K), R433.2, R434.2, U402.6 (-)
/EMG_CHANNEL_2_ANALOG/EMG2_RECT_SUM2: R436.2, R437.2, R438.2, U402.9 (-)
/EMG_CHANNEL_2_ANALOG/EMG2_RECT_U402B_DRV: D431.1 (K), D432.2 (A), U402.7
/EMG_CHANNEL_2_ANALOG/EMG2_REF_BIAS: C404.2, R403.2, R406.2
/EMG_CHANNEL_2_ANALOG/EMG2_REF_ELECTRODE: J401.S, R403.1
/EMG_CHANNEL_2_ANALOG/RG_A: R407.2, U401.1 (Rg)
/EMG_CHANNEL_2_ANALOG/RG_B: R407.1, U401.8 (Rg)
GND: C410.1, C421.2, C431.2, C451.2, C460.2, TP405.1 (1_1), U401.4 (V-), U402.11 (V-); also elsewhere on the board

Notes on the sheet:
EMG CHANNEL 2 ANALOG CHAIN - REVIEW CLEANUP
Safety notes: USB-powered human EMG testing forbidden.
Battery-isolated operation required for human-contact testing.
5V analog/ADC supply is not approved.
Sleeve/reference electrode is not GND.
Sheet interface: inputs 3V3_ADC, analog VREF, GND.
Outputs: EMG2_RAW, EMG2_RECT, EMG2_ENV.
ADC reference pin is intentionally not used in this analog sheet.
Rail sources are declared in the power/reference block.
1) TRS INPUT + PROTECTION
Tip = EMG2_IN_P. Ring = EMG2_IN_N. Sleeve = EMG2_REF_ELECTRODE.
Sleeve high-Z only; not GND/chassis.
2) INA333-CLASS GAIN STAGE
REF = analog VREF. Initial INA gain candidate = 21x.
3) RAW HPF / GAIN / LPF
AC-coupled RAW path re-biases to analog VREF, not GND.
4) RECT VREF-CENTERED ABS CANDIDATE
RECT implemented: U402B/U402C create reviewable VREF-centered abs rectifier.
Functional candidate for Channel 2 review only. Do not start PCB until reviewed.
5) ENV LPF / BUFFER
ENV LPF storage: C441 = 1uF from EMG2_ENV_LPF_NODE to analog VREF.
U402 power unit and C460 shown locally.
ADC INTERFACE CANDIDATES
ADC/output caps: C421/C431 = 1nF to GND; C451 = 4.7nF to GND.
Do not clamp to the ADC reference pin.
D431/D432 orientation notes: D431 A=A1_OUT K=U402B_DRV; D432 A=U402B_DRV K=SUM1.
RECT resistor roles: R433/R434/R437 = 10k; R436/R438 = 20k; R435 = 1M bias.
EMG2 RECT implemented VREF-centered absolute-value rectifier. Reviewable, not final hardware approval.

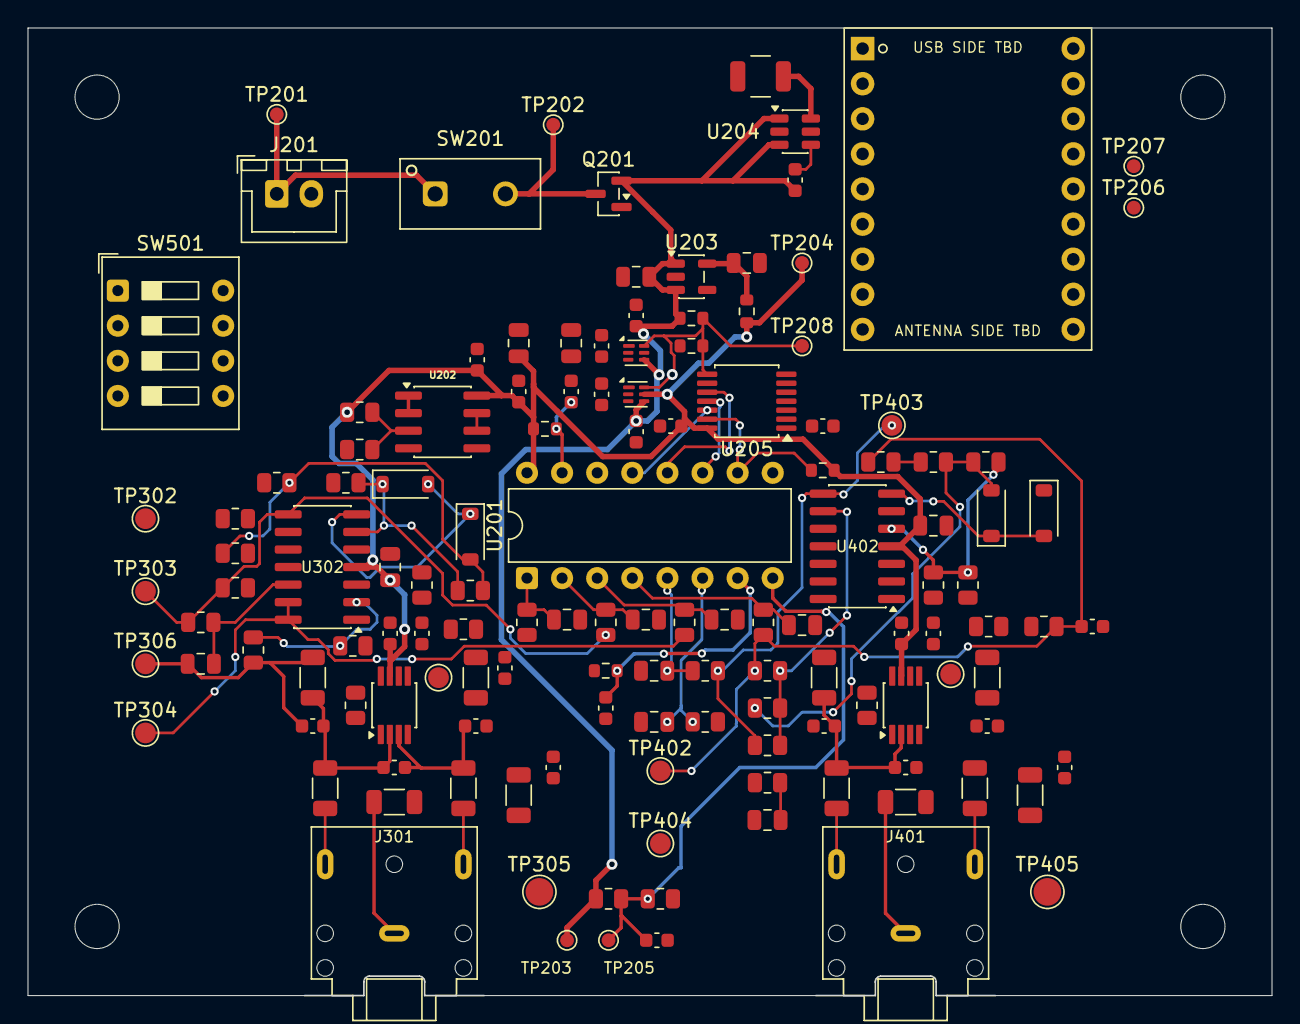
[picture p8: board EMG_v5.kicad_pcb from above]

Board: 2 copper layers, 90.0 x 70.0 mm, 134 parts (0 on the bottom side), 76 nets.
