Batuhxn/EMG/pre_trs_backup_20260628_022634/EMG_v4.kicad_pcb

## KiCad design pre_trs_backup_20260628_022634/EMG_v4.kicad_pcb (2026-07-01)

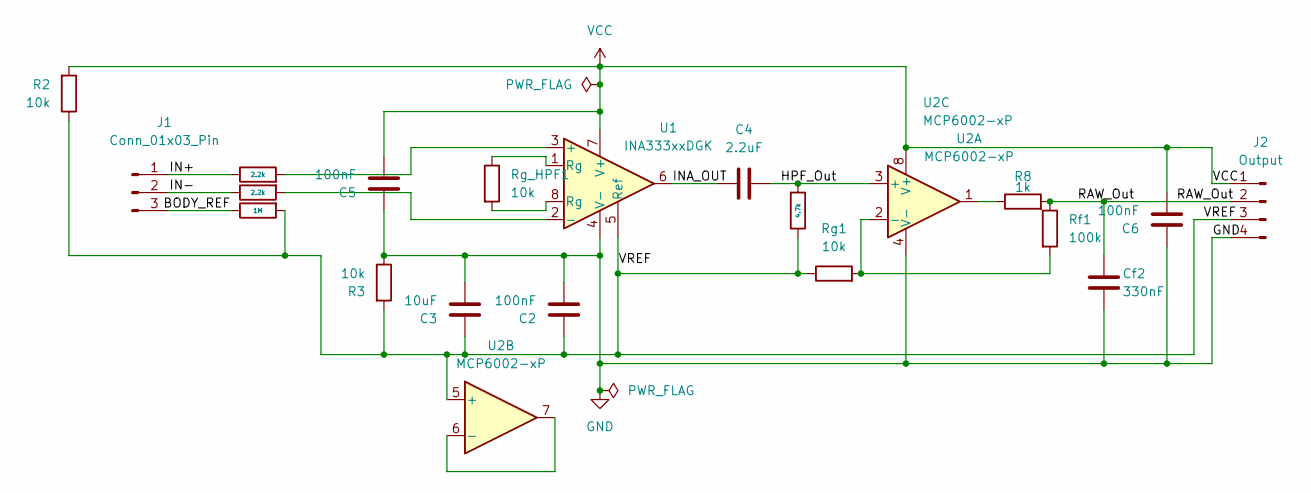
[picture p9: schematic EMG_v4.kicad_sch]

Parts:
C2, C5, C6: 100nF; C_Disc_D5.0mm_W2.5mm_P5.00mm
C3: 10uF; CP_Radial_D5.0mm_P2.50mm
C4: 2.2uF; C_Disc_D5.0mm_W2.5mm_P5.00mm
Cf2: 330nF; C_Disc_D5.0mm_W2.5mm_P5.00mm
J1: Conn_01x03_Pin; PinHeader_1x03_P2.54mm_Vertical
J2: Output; PinHeader_1x04_P2.54mm_Vertical
R2, R3: 10k; R_Axial_DIN0207_L6.3mm_D2.5mm_P7.62mm_Horizontal
R4, R5: 2.2k; R_Axial_DIN0207_L6.3mm_D2.5mm_P7.62mm_Horizontal
R6: 4.7k; R_Axial_DIN0207_L6.3mm_D2.5mm_P7.62mm_Horizontal
R7: 1M; R_Axial_DIN0207_L6.3mm_D2.5mm_P7.62mm_Horizontal
R8: 1k; R_Axial_DIN0207_L6.3mm_D2.5mm_P7.62mm_Horizontal
Rf1: 100k; R_Axial_DIN0207_L6.3mm_D2.5mm_P7.62mm_Horizontal
Rg1: 10k; R_Axial_DIN0207_L6.3mm_D2.5mm_P7.62mm_Horizontal
Rg_HPF1: 10k; R_Axial_DIN0207_L6.3mm_D2.5mm_P7.62mm_Horizontal
U1: INA333xxDGK; VSSOP-8_3x3mm_P0.65mm
U2: MCP6002-xP; DIP-8_W7.62mm

Connections:
/BODY_REF: J1.3, R7.1
/HPF_Out: C4.2, R6.2, U2.3 (+)
/IN+: J1.1, R4.1
/IN-: J1.2, R5.1
/INA_OUT: C4.1, U1.6
/RAW_Out: Cf2.2, J2.2, R8.2, Rf1.1
/VREF: C2.1, C3.1, J2.3, R2.1, R3.2, R6.1, R7.2, Rg1.1, U1.5 (Ref), U2.5 (+)
GND: C2.2, C3.2, C5.1, C6.1, Cf2.1, J2.4, R3.1, U1.4 (V-), U2.4 (V-)
unnamed: R8.1, U2.1
unnamed: Rg_HPF1.1, U1.1 (Rg)
unnamed: Rg_HPF1.2, U1.8 (Rg)
unnamed: R4.2, U1.3 (+)
unnamed: R5.2, U1.2 (-)
unnamed: Rf1.2, Rg1.2, U2.2 (-)
unnamed: U2.6 (-), U2.7
VCC: C5.2, C6.2, J2.1, R2.2, U1.7 (V+), U2.8 (V+)

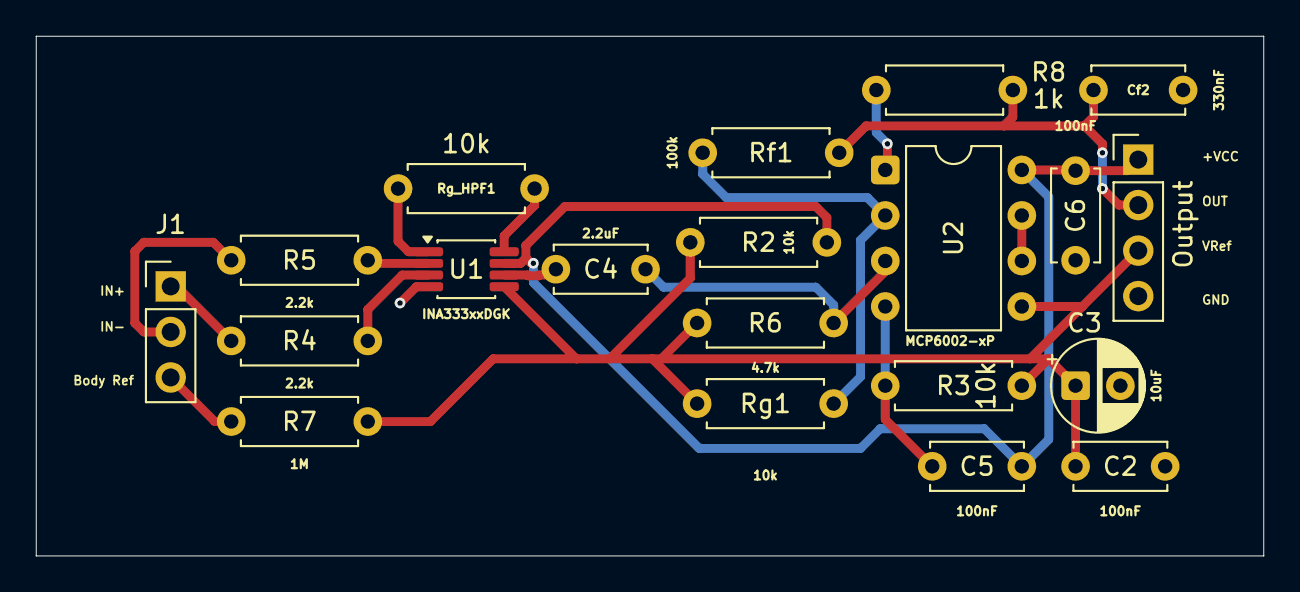
[picture p10: board EMG_v4.kicad_pcb from above]

Board: 2 copper layers, 68.5 x 29.0 mm, 20 parts (0 on the bottom side), 16 nets.
