Batuhxn/EMG/(commit log)

2026-07-01 emergency baseline from transferred EMG project
    [EMG_kullanilacak_komponentler_BoM.xlsx, EMG_v2_BOM_FIXED.xlsx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]
2026-07-01 add measured provisional DSTK22807 carrier footprint
2026-07-01 clean up DSTK22807 carrier footprint silkscreen
2026-07-01 document DSTK22807 SPI pin candidates
2026-07-01 document MCP3208 MPN symbol footprint review
2026-07-01 document V5 power reference architecture review
2026-07-01 document power reference component candidates
2026-07-01 document DSTK22807 power pin measurements
2026-07-01 update decisions with DSTK power measurements
2026-07-01 document battery regulator power path plan
2026-07-01 document power reference value level review
2026-07-01 update decisions with value level power review
2026-07-01 document power reference schematic block proposal
2026-07-01 update decisions with schematic block proposal
2026-07-02 document DSTK 3V3 rail current budget review
2026-07-02 update decisions with DSTK 3V3 current budget review
2026-07-02 document first schematic power source strategy
2026-07-02 update decisions with first power source strategy
2026-07-02 add power reference schematic block
    [EMG_v5.kicad_sch, POWER_REFERENCE_BLOCK.kicad_sch]
2026-07-02 sync docs with power reference schematic block
2026-07-02 fix power reference block ERC-critical issues
    [POWER_REFERENCE_BLOCK.kicad_sch]
2026-07-04 add channel 1 analog schematic candidate
    [EMG_CHANNEL_1_ANALOG.kicad_sch, EMG_v5.kicad_sch, POWER_REFERENCE_BLOCK.kicad_sch]
2026-07-04 fix channel 1 analog polarity and block rectifier placeholder
    [EMG_CHANNEL_1_ANALOG.kicad_sch]
2026-07-04 implement channel 1 rectifier candidate
    [EMG_CHANNEL_1_ANALOG.kicad_sch]
2026-07-06 cleanup channel 1 rectifier schematic readability
    [EMG_CHANNEL_1_ANALOG.kicad_sch]
2026-07-06 add measured DSTK22807 schematic symbol
2026-07-06 sync docs with rectifier diode decision
2026-07-06 sync docs with rectifier resistor matching decision
2026-07-06 sync docs with rectifier capacitor decision
2026-07-06 assign channel 1 rectifier footprints
    [EMG_CHANNEL_1_ANALOG.kicad_sch]
2026-07-06 sync docs with rectifier footprint assignment
2026-07-06 clarify channel 1 rectifier diode values
    [EMG_CHANNEL_1_ANALOG.kicad_sch]
2026-07-06 sync docs with rectifier diode value cleanup
2026-07-06 implement channel 2 analog schematic
    [EMG_CHANNEL_2_ANALOG.kicad_sch, EMG_v5.kicad_sch, POWER_REFERENCE_BLOCK.kicad_sch]
2026-07-06 remove legacy root emg schematic block
    [EMG_v5.kicad_sch]
2026-07-06 fix channel trs mapping and raw gain input polarity
    [EMG_CHANNEL_1_ANALOG.kicad_sch, EMG_CHANNEL_2_ANALOG.kicad_sch]
2026-07-07 cleanup unconnected schematic wire endpoints
    [EMG_CHANNEL_1_ANALOG.kicad_sch, EMG_CHANNEL_2_ANALOG.kicad_sch, POWER_REFERENCE_BLOCK.kicad_sch]
2026-07-07 cleanup MCP6004 symbol metadata mismatch
    [EMG_CHANNEL_1_ANALOG.kicad_sch, EMG_CHANNEL_2_ANALOG.kicad_sch]
2026-07-07 cleanup Schottky diode symbol metadata mismatch
    [EMG_CHANNEL_1_ANALOG.kicad_sch, EMG_CHANNEL_2_ANALOG.kicad_sch]
2026-07-07 place unused U202B op amp unit safely
    [POWER_REFERENCE_BLOCK.kicad_sch]
2026-07-08 connect dstk spi and mark unused pins
    [EMG_v5.kicad_sch, POWER_REFERENCE_BLOCK.kicad_sch]
2026-07-08 sync kicad metadata and analog label placement
    [EMG_CHANNEL_1_ANALOG.kicad_sch, EMG_CHANNEL_2_ANALOG.kicad_sch]
2026-07-08 sync docs with dstk spi integration
2026-07-08 sync docs with dstk power strategy
2026-07-08 sync docs with local 3v3 adc regulator plan
2026-07-08 sync docs with first 3xaa battery decision
2026-07-09 refine root schematic layout
    [EMG_v5.kicad_sch]
2026-07-09 sync docs with tps7a2033 current budget review
2026-07-09 sync docs with pmos batmon and spi offpower review
2026-07-09 implement first validation 3xaa power path
    [POWER_REFERENCE_BLOCK.kicad_sch]
2026-07-09 sync power helper symbols and refine schematic layout
    [POWER_REFERENCE_BLOCK.kicad_sch]
2026-07-10 sync v5 engineering docs with implemented power checkpoint
2026-07-10 document spi unequal-power disconnect decision
2026-07-11 add mcp3208 cs pullup
    [POWER_REFERENCE_BLOCK.kicad_sch]
2026-07-11 finalize vref monitor capacitor at 220pf
    [POWER_REFERENCE_BLOCK.kicad_sch]
2026-07-11 finalize u202 local decoupling capacitor
    [POWER_REFERENCE_BLOCK.kicad_sch]
2026-07-11 finalize adc reference network values
    [POWER_REFERENCE_BLOCK.kicad_sch]
2026-07-11 finalize 3v3 adc rail decoupling values
    [POWER_REFERENCE_BLOCK.kicad_sch]
2026-07-11 remap adc sclk to gpio4
    [EMG_v5.kicad_sch]
2026-07-13 add battery powered carrier supply path
    [EMG_v5.kicad_sch, POWER_REFERENCE_BLOCK.kicad_sch]
2026-07-21 fix trs electrode terminal mapping
    [EMG_CHANNEL_1_ANALOG.kicad_sch, EMG_CHANNEL_2_ANALOG.kicad_sch]
2026-07-21 add unequal-power spi isolation
    [EMG_v5.kicad_sch, POWER_REFERENCE_BLOCK.kicad_sch]
2026-07-21 sync firmware spi gpio mapping
2026-07-21 resolve remaining erc warnings
    [POWER_REFERENCE_BLOCK.kicad_sch]
2026-07-21 assign first passive footprint batch
    [POWER_REFERENCE_BLOCK.kicad_sch]
2026-07-21 assign mirrored analog footprint batch
    [EMG_CHANNEL_1_ANALOG.kicad_sch, EMG_CHANNEL_2_ANALOG.kicad_sch]
2026-07-21 select and assign analog ic packages
    [EMG_CHANNEL_1_ANALOG.kicad_sch, EMG_CHANNEL_2_ANALOG.kicad_sch, POWER_REFERENCE_BLOCK.kicad_sch]
2026-07-21 assign analog input filter footprints
    [EMG_CHANNEL_1_ANALOG.kicad_sch, EMG_CHANNEL_2_ANALOG.kicad_sch]
2026-07-21 retain footprints for optional dnp filters
    [EMG_CHANNEL_1_ANALOG.kicad_sch, EMG_CHANNEL_2_ANALOG.kicad_sch]
2026-07-21 select and assign mechanical interface parts
    [EMG_CHANNEL_1_ANALOG.kicad_sch, EMG_CHANNEL_2_ANALOG.kicad_sch, POWER_REFERENCE_BLOCK.kicad_sch]
2026-08-02 sync u204 symbol with kicad 10.0.4
    [POWER_REFERENCE_BLOCK.kicad_sch]
2026-08-05 assign final resistor footprints
    [EMG_CHANNEL_1_ANALOG.kicad_sch, EMG_CHANNEL_2_ANALOG.kicad_sch, POWER_REFERENCE_BLOCK.kicad_sch]
2026-08-05 Assign Murata GRM32 footprint and update C213 to 47uF
    [POWER_REFERENCE_BLOCK.kicad_sch]
2026-08-06 Place EMG V5 PCB blocks and fix analog feedback nets
    [EMG_CHANNEL_1_ANALOG.kicad_sch, EMG_CHANNEL_2_ANALOG.kicad_sch, EMG_v5.kicad_pcb, EMG_v5.kicad_sch, POWER_REFERENCE_BLOCK.kicad_sch]
2026-08-06 Complete V5 PCB placement and debug access
    [EMG_CHANNEL_1_ANALOG.kicad_sch, EMG_CHANNEL_2_ANALOG.kicad_sch, EMG_v5.kicad_pcb, EMG_v5.kicad_sch, POWER_REFERENCE_BLOCK.kicad_sch]
2026-08-07 Update V5 routing and INA333 footprint
    [EMG_CHANNEL_1_ANALOG.kicad_sch, EMG_CHANNEL_2_ANALOG.kicad_sch, EMG_v5.kicad_pcb]
2026-08-10 docs(bom): add verified EMG V5 purchasing BOM
